EmbeddedSystemClass/Motor-Driver/README.md

# Motor-Driver

Collection of all boards past and presenet used by UOE Racing. Boards are organized by year of competition
