EmbeddedSystemClass/Motor-Driver/2019-2020/Diagrams/Motor Board Control Overview.png

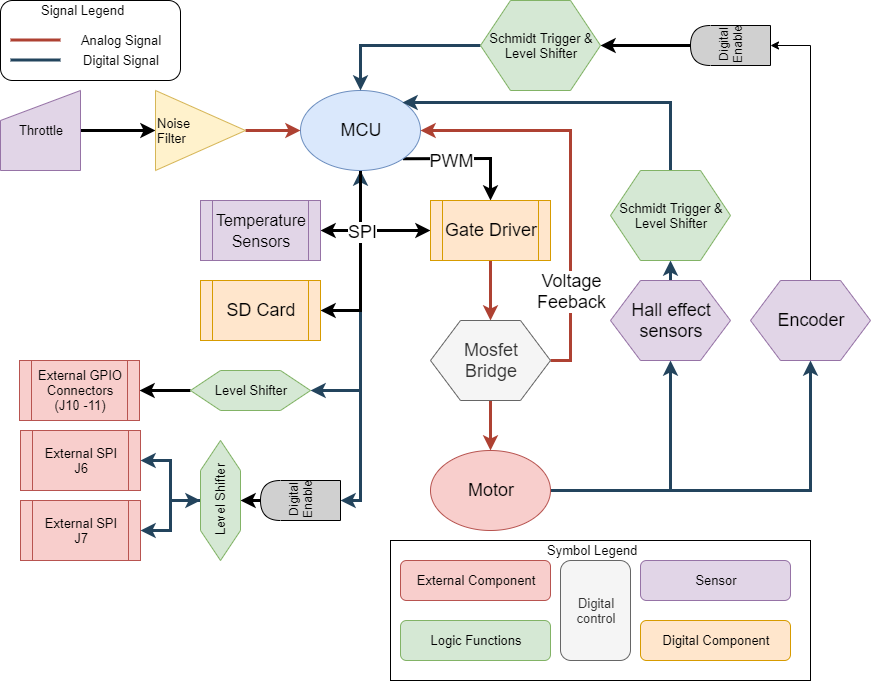
2019-2020/Diagrams/Motor Board Control Overview.png
