EmbeddedSystemClass/Motor-Driver/2019-2020/Diagrams/Power Block Diagram.png

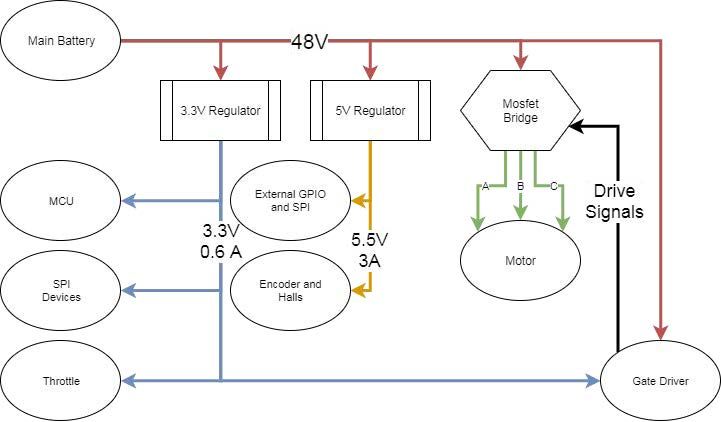
2019-2020/Diagrams/Power Block Diagram.png
