EmbeddedSystemClass/Motor-Driver/Part Libraries/ECAR_Refrence_Libary/OTHER/SW3639/NTAG I2C plus Class4 Antenna v1 screenshot.PNG

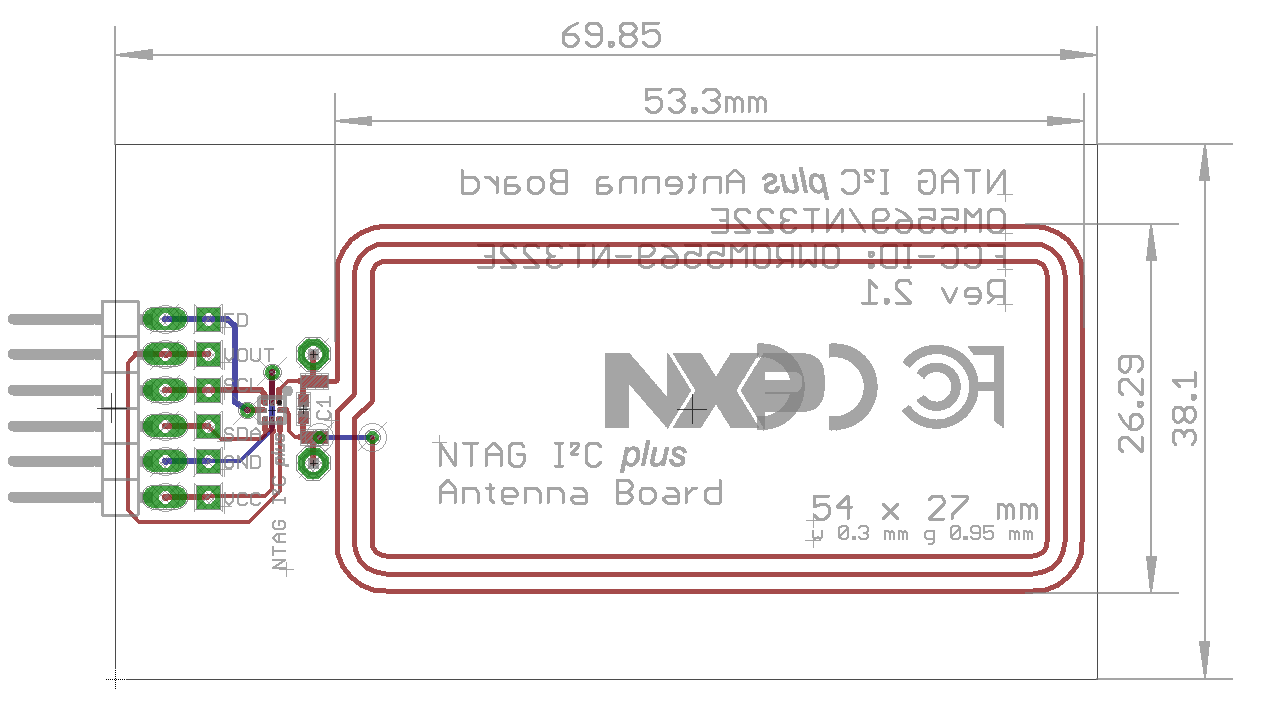
Part Libraries/ECAR_Refrence_Libary/OTHER/SW3639/NTAG I2C plus Class4 Antenna v1 screenshot.PNG
