EmbeddedSystemClass/Motor-Driver/Part Libraries/ECAR_Refrence_Libary/EReference-Schematic.csv

LIBRARYREFERENCE | FOOTPRINT1 | ACCURACY | CAPACITANCE | CASE CODE (IMPERIAL) | CASE CODE (METRIC) | CASE/PACKAGE | COLOUR | COMMENT | COMPONENTLINK1DESCRIPTION | COMPONENTLINK1URL | COMPONENTLINK2DESCRIPTION | COMPONENTLINK2URL | COMPONENTLINK3DESCRIPTION | COMPONENTLINK3URL | COMPONENTLINK4DESCRIPTION | COMPONENTLINK4URL | COMPONENTLINK5DESCRIPTION | COMPONENTLINK5URL | COMPONENTLINK6DESCRIPTION | COMPONENTLINK6URL | COMPONENTLINK7DESCRIPTION | COMPONENTLINK7URL | COMPONENTLINK8DESCRIPTION | COMPONENTLINK8URL | COMPOSITION | CONTACT PLATING | CONTINUOUS DRAIN CURRENT (ID) | CORE MATERIAL | CURRENT | CURRENT RATING | DATA RATE | DC RESISTANCE (DCR) | DEPTH | DIAMETER | DIELECTRIC | DIELECTRIC MATERIAL | DISSIPATION FACTOR | DOMINANT WAVELENGTH | DRAIN TO SOURCE BREAKDOWN VOLTAGE | DRAIN TO SOURCE RESISTANCE | DRAIN TO SOURCE VOLTAGE (VDSS) | DROPOUT VOLTAGE | ELEMENT CONFIGURATION | FALL TIME | FEATURES | FORWARD CURRENT | FORWARD VOLTAGE | FREQUENCY | GATE TO SOURCE VOLTAGE (VGS) | HALOGEN FREE | HEIGHT | HEIGHT - SEATED (MAX) | ILLUMINATION COLOUR | INDUCTANCE | INPUT CAPACITANCE | INTERFACE | LEAD DIAMETER | LEAD FREE | LEAD PITCH
ASMPH-1008-2R2M-T | INDC2521X10L |  |  | 1008 | 2520 | 1008 |  | 2.2uH | http://www.abracon.com/Magnetics/power/ASMPH-1008.pdf | http://www.abracon.com/Magnetics/power/ASMPH-1008.pdf |  |  |  |  |  |  |  |  |  |  |  |  |  |  |  |  |  | Ferrite |  | 1.3A |  | 80mR |  |  |  |  |  |  |  |  |  |  |  |  |  |  |  |  |  |  | 0.9mm | 0.039inch |  | 2.2uh
ASV-10.000MHZ-LCS-T | ASV-10.000MHZ-LCS-T |  |  |  |  |  |  | 10Mhz | DataSheet | https://abracon.com/Oscillators/ASV.pdf | Digikey Page | https://www.digikey.ca/product-detail/en/abracon-llc/ASV-10.000MHZ-LCS-T/535-13490-1-ND/5980162
C1005C0G1H680G050BA | CAPC1608X05L |  | 68pF | 0402 | 1005 | 0402 |  | 1uF | http://www.mouser.com/ds/2/400/lcc_commercial_general_en-837201.pdf | http://www.mouser.com/ds/2/400/lcc_commercial_general_en-837201.pdf | https://product.tdk.com/info/en/documents/chara_sheet/C1005C0G1H680G050BA.pdf | https://product.tdk.com/info/en/documents/chara_sheet/C1005C0G1H680G050BA.pdf |  |  |  |  |  |  |  |  |  |  |  |  |  |  |  |  |  |  |  |  | 0.5mm |  | C0G | Ceramic |  |  |  |  |  |  |  |  |  |  |  |  |  |  | 0.5mm |  |  |  |  |  |  | Lead Free
CC0603JRX7R9BB104 | CAPC1608X05L |  | 100nF | 0603 | 1608 | 0603 |  | 0.1uF | http://www.yageo.com/documents/recent/UPY-GPHC_X7R_6.3V-to-50V_8.pdf | http://www.yageo.com/documents/recent/UPY-GPHC_X7R_6.3V-to-50V_8.pdf |  |  |  |  |  |  |  |  |  |  |  |  |  |  | Ceramic |  |  |  |  |  |  |  | 0.8mm |  | X7R |  |  |  |  |  |  |  |  |  |  |  |  |  |  | Halogen Free | 0.8mm |  |  |  |  |  |  | Lead Free
CL10A106MQ8NNNC | CAPC1608X05L |  | 10uF | 0603 | 1608 | 0603 |  | 10uF | http://www.samsungsem.com/kr/support/library/product-catalog/mlcc.jsp | http://www.samsungsem.com/kr/support/library/product-catalog/mlcc.jsp | https://www.verical.com/server-webapp/html/getDatasheet?partID=357557 | https://www.verical.com/server-webapp/html/getDatasheet?partID=357557 | http://www1.futureelectronics.com/doc/SAMSUNG%20PASSIVE/CL05B104KQ5NNNC.pdf | http://www1.futureelectronics.com/doc/SAMSUNG%20PASSIVE/CL05B104KQ5NNNC.pdf |  |  |  |  |  |  |  |  |  |  |  | Tin |  |  |  |  |  |  | 0.8mm |  | X5R |  |  |  |  |  |  |  |  |  |  |  |  |  |  |  | 0.8mm
CL10A475MP5LNNC | CAPC1608X05L |  | 4.7uF | 0603 | 1608 | 0603 |  | 4.7uF |  |  |  |  |  |  |  |  |  |  |  |  |  |  |  |  |  | Tin |  |  |  |  |  |  |  |  | X5R
CL10F104ZB8NNNC | CAPC1608X05L |  | 100nF | 0603 | 1608 | 0603 |  | 0.1uF | http://www1.futureelectronics.com/doc/SAMSUNG/CL10F104ZB8NNNC.pdf | http://www1.futureelectronics.com/doc/SAMSUNG/CL10F104ZB8NNNC.pdf | https://www.verical.com/server-webapp/html/getDatasheet?partID=355329 | https://www.verical.com/server-webapp/html/getDatasheet?partID=355329 | https://www.distrelec.biz/Web/Downloads/_e/ng/MLCC_CatalogDownload2013_ENG.pdf?mime=application%2Fpdf | https://www.distrelec.biz/Web/Downloads/_e/ng/MLCC_CatalogDownload2013_ENG.pdf?mime=application%2Fpdf | https://produktinfo.conrad.com/datenblaetter/450000-474999/456692-da-01-en-VS_KONDENSATOR_0603.pdf | https://produktinfo.conrad.com/datenblaetter/450000-474999/456692-da-01-en-VS_KONDENSATOR_0603.pdf |  |  |  |  |  |  |  |  |  | Tin |  |  |  |  |  |  | 0.8mm |  | Y5V |  |  |  |  |  |  |  |  |  |  |  |  |  |  |  | 0.8mm
DRV8323RSRGZR | QFN50P700X700X100_HS-49N |  |  |  |  |  |  | *
ERA-3AEB121V | CAPC1608X05L |  |  | 0603 | 1608 | 0603 |  | 120 | http://www.farnell.com/datasheets/1776116.pdf | http://www.farnell.com/datasheets/1776116.pdf | https://www.distrelec.biz/Web/Downloads/_t/ds/ERA_eng_tds.pdf?mime=application%2Fpdf | https://www.distrelec.biz/Web/Downloads/_t/ds/ERA_eng_tds.pdf?mime=application%2Fpdf | http://www.farnell.com/datasheets/485442.pdf | http://www.farnell.com/datasheets/485442.pdf | http://www.farnell.com/datasheets/2052875.pdf | http://www.farnell.com/datasheets/2052875.pdf | http://www.farnell.com/datasheets/2059650.pdf | http://www.farnell.com/datasheets/2059650.pdf | http://industrial.panasonic.com/www-data/pdf/AOA0000/AOA0000CE26.pdf | http://industrial.panasonic.com/www-data/pdf/AOA0000/AOA0000CE26.pdf | http://uk.rs-online.com/webdocs/0fe2/0900766b80fe20f7.pdf | http://uk.rs-online.com/webdocs/0fe2/0900766b80fe20f7.pdf | https://produktinfo.conrad.com/datenblaetter/450000-474999/450380-da-01-en-WIDERSTAND_0603_ERA.pdf | https://produktinfo.conrad.com/datenblaetter/450000-474999/450380-da-01-en-WIDERSTAND_0603_ERA.pdf | Thin Film | Tin |  |  |  |  |  |  | 0.8mm |  |  |  |  |  |  |  |  |  |  |  | Automotive AEC-Q200 |  |  |  |  |  | 0.45mm |  |  |  |  |  |  | Lead Free
ERJ-M1WTF2M0U | RESC6532X08L |  |  | 2512 | 6432 | 2512 |  | 0.002 | http://uk.rs-online.com/webdocs/0bef/0900766b80befc3b.pdf | http://uk.rs-online.com/webdocs/0bef/0900766b80befc3b.pdf | http://www.farnell.com/datasheets/39800.pdf | http://www.farnell.com/datasheets/39800.pdf | http://www.farnell.com/datasheets/1678791.pdf | http://www.farnell.com/datasheets/1678791.pdf | http://www.mouser.com/ds/2/315/AOA0000CE7-60136.pdf | http://www.mouser.com/ds/2/315/AOA0000CE7-60136.pdf | https://www.alliedelec.com/m/d/7be8c991d0d271c40a5d4721d31e0fd6.pdf | https://www.alliedelec.com/m/d/7be8c991d0d271c40a5d4721d31e0fd6.pdf | https://industrial.panasonic.com/cdbs/www-data/pdf/RDN0000/AOA0000C90.pdf | https://industrial.panasonic.com/cdbs/www-data/pdf/RDN0000/AOA0000C90.pdf | http://industrial.panasonic.com/www-data/pdf/AOA0000/AOA0000CE7.pdf | http://industrial.panasonic.com/www-data/pdf/AOA0000/AOA0000CE7.pdf | https://www.alliedelec.com/m/d/0d7a6c47246abe4d76f460def559c8b0.pdf | https://www.alliedelec.com/m/d/0d7a6c47246abe4d76f460def559c8b0.pdf | Metal Element,Metal Strip,Thick Film | Tin |  |  |  |  |  |  | 3.2mm |  |  |  |  |  |  |  |  |  |  |  |  |  |  |  |  |  | 0.8mm |  |  |  |  |  |  | Lead Free
F280049CPMS | TSQFP50P1200X1200X145-64N |  |  |  |  |  |  | * | Digikey | https://www.digikey.ca/product-detail/en/texas-instruments/F280049CPMS/296-49637-ND/8322725 | Datasheet | http://www.ti.com/lit/ds/symlink/tms320f280049c.pdf | Ti Store Page | http://www.ti.com/product/tms320f280049c
FQD9N25TM_F080 | DPAK229P991X239-3N |  |  |  |  | TO-252-3 |  | * | https://www.fairchildsemi.com/tape-and-reel-drawings/PKG-TO252A03.pdf | https://www.fairchildsemi.com/tape-and-reel-drawings/PKG-TO252A03.pdf | https://www.fairchildsemi.com/datasheets/FQ/FQD9N25.pdf | https://www.fairchildsemi.com/datasheets/FQ/FQD9N25.pdf |  |  |  |  |  |  |  |  |  |  |  |  |  |  | 7.4A |  |  |  |  |  |  |  |  |  |  |  | 250V | 420mR | 250V |  | Single | 45ns |  |  |  |  | 30V |  |  |  |  |  | 700pF
ISO1050DUBR | SOP254P1040X485-8N |  |  |  |  | SOP |  |  | http://www.ti.com/lit/ds/symlink/iso1050.pdf | http://www.ti.com/lit/ds/symlink/iso1050.pdf | http://www.farnell.com/datasheets/1972904.pdf | http://www.farnell.com/datasheets/1972904.pdf | https://www.verical.com/server-webapp/html/getDatasheet?partID=330373 | https://www.verical.com/server-webapp/html/getDatasheet?partID=330373 | http://sg.element14.com/webapp/wcs/stores/servlet/OpenCAD?id=800000158048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 | http://sg.element14.com/webapp/wcs/stores/servlet/OpenCAD?id=800000158048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 | http://www.produktinfo.conrad.com/datenblaetter/1100000-1199999/001187118-da-01-en-IC_TXRX_CAN_5V_ISO_ISO1050DUBR_SOP_8_TID.pdf | http://www.produktinfo.conrad.com/datenblaetter/1100000-1199999/001187118-da-01-en-IC_TXRX_CAN_5V_ISO_ISO1050DUBR_SOP_8_TID.pdf | http://datasheet.iiic.cc/texas_instruments/ISO1050DUBR.pdf | http://datasheet.iiic.cc/texas_instruments/ISO1050DUBR.pdf |  |  |  |  |  | Gold |  |  |  |  | 1Mbps |  |  |  |  |  |  |  |  |  |  |  |  |  |  |  |  |  |  |  |  |  |  |  |  |  |  | Lead Free
LTST-C191KRKT | CAPC1608X05L - Polarized |  |  | 0603 | 1608 | 0603 | Red | RED LED | http://optoelectronics.liteon.com/upload/download/DS22-2000-223/LTST-C191KRKT.PDF | http://optoelectronics.liteon.com/upload/download/DS22-2000-223/LTST-C191KRKT.PDF | http://www1.futureelectronics.com/doc/LITE-ON/LTST-C191KRKT.pdf | http://www1.futureelectronics.com/doc/LITE-ON/LTST-C191KRKT.pdf | https://www.verical.com/server-webapp/html/getDatasheet?partID=141922 | https://www.verical.com/server-webapp/html/getDatasheet?partID=141922 | http://www.mouser.com/ds/2/239/LTST-C191KRKT-1140668.pdf | http://www.mouser.com/ds/2/239/LTST-C191KRKT-1140668.pdf |  |  |  |  |  |  |  |  |  |  |  |  | 2A |  |  |  | 0.8mm |  |  |  |  | 631nm |  |  |  |  |  |  |  | 30mA | 2V |  |  |  | 0.55mm |  | Red |  |  |  |  | Lead Free
NT3H2211W0FT1X | SOP254P1040X485-8N |  |  |  |  | SOIC |  | * |  |  |  |  |  |  |  |  |  |  |  |  |  |  |  |  |  |  |  |  |  |  |  |  |  |  |  |  |  |  |  |  |  |  |  |  |  |  |  | 13.56MHz |  |  |  |  |  |  |  | I2C
RC0603JR-0743RL | CAPC1608X05L |  |  | 0603 | 1608 | 0603 |  | 43 | http://www.yageo.com/documents/recent/PYu-RC_Group_51_RoHS_L_9.pdf | http://www.yageo.com/documents/recent/PYu-RC_Group_51_RoHS_L_9.pdf | http://www.yageo.com.tw/exep/pages/download/literatures/PYu-R_INT-thick_7.pdf | http://www.yageo.com.tw/exep/pages/download/literatures/PYu-R_INT-thick_7.pdf | http://www.mouser.com/ds/2/447/RC0603-272842.pdf | http://www.mouser.com/ds/2/447/RC0603-272842.pdf |  |  |  |  |  |  |  |  |  |  | Thick Film | Matte,Tin |  |  |  |  |  |  | 0.8mm |  |  |  |  |  |  |  |  |  |  |  | Moisture Resistant |  |  |  |  |  | 0.022inch |  |  |  |  |  |  | Lead Free
RR0816P-103-D | CAPC1608X05L |  |  | 0603 | 1608 | 0603 |  | 10k | http://documents.rs-components.com/techlib://itc_doclist_GB.htm?stockno=3915321 | http://documents.rs-components.com/techlib://itc_doclist_GB.htm?stockno=3915321 | http://www.susumu.co.jp/common/pdf/n_catalog_partition05_en.pdf | http://www.susumu.co.jp/common/pdf/n_catalog_partition05_en.pdf |  |  |  |  |  |  |  |  |  |  |  |  | Thin Film |  |  |  |  |  |  |  | 0.8mm |  |  |  |  |  |  |  |  |  |  |  |  |  |  |  |  |  | 0.4mm |  |  |  |  |  |  | Lead Free
SMD Jumper |  |  |  |  |  |  |  | *
SSM3J35MFV,L3F | SOTFL40P120X55-3N |  |  |  |  | SOT-723 |  | * |  |  |  |  |  |  |  |  |  |  |  |  |  |  |  |  |  |  | 100mA |  |  |  |  |  |  |  |  |  |  |  |  |  | 20V |  |  |  |  |  |  |  |  |  |  |  |  |  | 12.2pF
UA78L05ACPK | SOT89-150P410X160-3N | 5% |  |  |  | SOT-89 |  |  | https://www.verical.com/server-webapp/html/getDatasheet?partID=40762 | https://www.verical.com/server-webapp/html/getDatasheet?partID=40762 | http://www.ti.com/lit/ds/symlink/ua78l.pdf | http://www.ti.com/lit/ds/symlink/ua78l.pdf | http://focus.ti.com/lit/ds/symlink/ua78l12a.pdf | http://focus.ti.com/lit/ds/symlink/ua78l12a.pdf | http://www.ti.com/general/docs/lit/getliterature.tsp?genericPartNumber=UA78L05&&fileType=pdf | http://www.ti.com/general/docs/lit/getliterature.tsp?genericPartNumber=UA78L05&&fileType=pdf | http://www.jameco.com/Jameco/Products/ProdDS/764220.pdf | http://www.jameco.com/Jameco/Products/ProdDS/764220.pdf | http://www.farnell.com/datasheets/1848990.pdf | http://www.farnell.com/datasheets/1848990.pdf |  |  |  |  |  | Matte,Tin |  |  |  |  |  |  |  |  |  |  |  |  |  |  |  | 1.7V |  |  |  |  |  |  |  |  |  |  |  |  |  |  |  | Lead Free
UMK107AB7105KA-T | CAPC1608X05L |  | 1uF | 0603 | 1608 | 0603 |  | 1uF | https://www.yuden.co.jp/productdata/catalog/mlcc_all_e.pdf | https://www.yuden.co.jp/productdata/catalog/mlcc_all_e.pdf |  |  |  |  |  |  |  |  |  |  |  |  |  |  |  |  |  |  |  |  |  |  | 0.8mm |  | X7R |  |  |  |  |  |  |  |  |  |  |  |  |  |  | Halogen Free | 0.8mm
UWT0J102MNL1GS | CAPAE109103X100N |  | 1mF |  |  | Radial |  | 1000uF | http://www.nichicon.co.jp/english/products/pdfs/e-ch_ref.pdf | http://www.nichicon.co.jp/english/products/pdfs/e-ch_ref.pdf | http://uk.rs-online.com/webdocs/0fa3/0900766b80fa3a91.pdf | http://uk.rs-online.com/webdocs/0fa3/0900766b80fa3a91.pdf | http://nichicon-us.com/english/products/pdfs/e-uwt.pdf | http://nichicon-us.com/english/products/pdfs/e-uwt.pdf | http://products.nichicon.co.jp/en/pdf/XJA043/e-wt.pdf | http://products.nichicon.co.jp/en/pdf/XJA043/e-wt.pdf | http://www.farnell.com/datasheets/1910938.pdf | http://www.farnell.com/datasheets/1910938.pdf | http://nichicon-us.com/english/products/pdfs/e-wt.pdf | http://nichicon-us.com/english/products/pdfs/e-wt.pdf |  |  |  |  |  |  |  |  |  |  |  |  |  | 8mm |  | Aluminium | 0.3% |  |  |  |  |  |  |  | General Purpose |  |  |  |  |  | 10mm | 0.315inch |  |  |  |  | 1.1mm | Lead Free | 3.1mm
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
