EmbeddedSystemClass/Motor-Driver/2018-19/Project Outputs for MOSFET Board Project/Power_Board_Layout_V2.xls

Sheet: Part List Report
 | Component list |  |  | Bill of Materials For PCB Document [Power_Board_Layout_V2.PcbDoc]
 | Source Data From: V2 |  |  | Mosfet Board V2
 | Project: BLDC Contorller Power Section |  |  | Generated from : 'Power_Board_Layout_V2.PcbDoc
 | Report Date: |  | 2/15/2019 | 10:30:46 AM
 | Print Date: |  | 2019-02-18 | 11:54:25
# | Designator | Manufacturer | Manufacturer Part Number | Value | Footprint | Description | Quantity | Price
1 | C1 | AVX Corporation | 08055C103KAT2A | 100nF | 805 | CAP CER 10000PF 50V X7R 0805 | 1 | 0.21
2 | C13, C16, C2 | Taiyo Yuden | UMK212B7105KG-T | 1uF | 805 | CAP CER 1UF 50V X7R 0805 | 3 | 0.3
3 | C14, C19, C20, C21 | Murata | GCJ188R71H473KA12D | 47nF | 603 | 0.047µF ±10% 50V Ceramic Capacitor X7R 0603 (1608 Metric) | 4 | 0.45
4 | C15, C17 | Yageo | CC0603KRX7R9BB104 | 0.1uF | 603 | CAP CER 0.1UF 50V X7R 0603 | 2 | 0.17
 | C3 | Murata | GRT21BR61E226ME13L | 22uF | 805 | CAP CER 22UF 25V X5R 0805 | 1 | 1.03
6 | C4, C5, C6 | Panasonic | ECA-1JHG471 | 470uF | Through Hole | Cap Aluminum Lytic 470uF 63V 20% (12.5 X 20mm) Radial 5mm 640mA 2000h 105C Bulk | 3 | 1.35
7 | C7, C8, C9 | Kyocera AVX | 06035C163KAT2A | 16nF | 603 | CAP CER 0.016UF 50V X7R 0603 | 3 | 0.5
8 | D1, D2 | Vishay Lite-On | LTST-C191KRKT |  | 603 | LED RED CLEAR 0603 SMD | 2 | 0.41
9 | D3, D4 | Micro Commercial | SMBJ5362B-TP |  |  | DIODE ZENER 28V 5W DO214AA | 2 | 0.96
10 | J3 | Molex | 39301240 |  | Through Hole | CONN HEADER R/A 24POS 4.2MM | 1 | 5.56
 | J6 | Hirose | DF3A-5P-2DSA |  | Through Hole | CONN HEADER VERT 5POS 2MM | 1 | 0.37
12 | L1 | Bourns INC | SRR6038-100Y | 10uH | Non-Standard SMT | FIXED IND 10UH 2A 38 MOHM SMD | 1 | 1.31
13 | Q1, Q2, Q3, Q4, Q5, Q6 | Texas Instruments | CSD18536KTTT |  | DPAK254P1510X470-3M | MOSFET N-CH 60V 200A D2PAK | 6 | 7.44
14 | R1 | Susumu | RR0816P-104-D | 100k | 603 | RES SMD 100K OHM 0.5% 1/16W 0603 | 1 | 0.17
15 | R15, R16, R17 | Stackpole Electronics | CSNL2512FT1L00 | 0.001 | RESC8032X08N | RES 0.001 OHM 1% 2W 2512 | 3 | 1.03
16 | R2 | Yageo | RC0603FR-0722KL | 22k | 603 | RES SMD 22K OHM 1% 1/10W 0603 | 1 | 0.15
17 | R20, R21, R22 | Panasonic | ERA-3AEB4222V | 42.2K | 603 | RES SMD 42.2KOHM 0.1% 1/10W 0603 | 3 | 0.53
18 | R23, R24, $25 | Panasonic | ERA-3AEB4991V | 4.99K | 603 | RES SMD 4.99KOHM 0.1% 1/10W 0603 | 3 | 0.53
19 | R3, R4, R5, R11, R12, R18, R19 | Stackpole Electronics | RMCF0603JT10K0 | 10k | 603 | RES 10K OHM 5% 1/10W 0603 | 7 | 0.15
20 | R6, R7, R8, R10, R13, R14 | TE Connectivity | CRG0603J100R | 100 | 603 | RES SMD 100 OHM 5% 1/10W 0603 | 6 | 0.15
21 | R9 | Rohm | SDR03EZPJ152 | 1.5K | 0805 Res | RES SMD 1.5 KOHM 5% 0.3W 0603 | 1 | 0.15
22 | TP1, TP2, TP3, TP13 | TE Connectivity | RCU-0C |  |  | PC TEST POINT NATURAL | 4 | 0.31
23 | U1 | Texas Instruments | TPS54308DDCR |  | SOT95P280X110-6N | FCCM SYNCHRONOUS STEP DOWN CONVE | 1 | 2.42
24 | U2 | Texas Instruments | DRV8323RSRGZT |  | QFN50P700X700X100_HS-49N | IC MTR DRV MULTIPHAS 6-60V 48QFN | 1 | 8.97
Approved |  |  |  | Notes |  |  | 61 | 95.62
 |  |  |  | Prepared By Camry Mabon

Sheet: Project Information
Project Full Path | C:\Users\squir\Desktop\bldc_power_board\MOSFET Board Project.PrjPCB
Project Filename | MOSFET Board Project.PrjPCB
Variant Name | None
Data-Source Filename | Power_Board_Layout_V2.PcbDoc
Data-Source Full Path | C:\Users\squir\Desktop\bldc_power_board\Power_Board_Layout_V2.PcbDoc
Title | Bill of Materials For PCB Document [Power_Board_Layout_V2.PcbDoc]
Total Quantity | 65
Report Time | 10:30:46 AM
Report Date | 2/15/2019
Report Date & Tine | 2/15/2019 10:30:46 AM
Output Name | Bill of Materials
Output Type | BOM_PartType
Output Generator Name | BOM
Output Generator Description | Bill of Materials
Total Actual Price | 0
Total Target Price | 0
