EmbeddedSystemClass/Motor-Driver/2018-19/Power_Board_Layout_V2.step

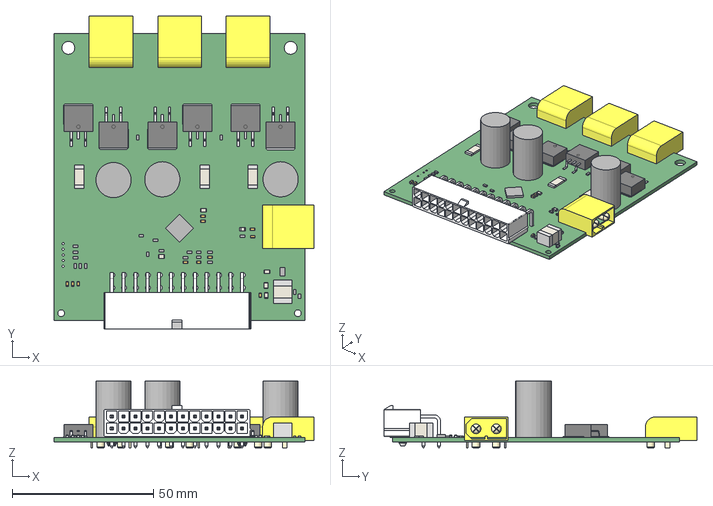
[picture p4: CAD file, 2019-07-14]
2018-19/Power_Board_Layout_V2.step
92.1 x 110.7 x 23.6 mm
