EmbeddedSystemClass/Motor-Driver/Part Libraries/ECAR_Refrence_Libary/OTHER/3D Models/MPT-06-01-03-L-RA-SD.stp

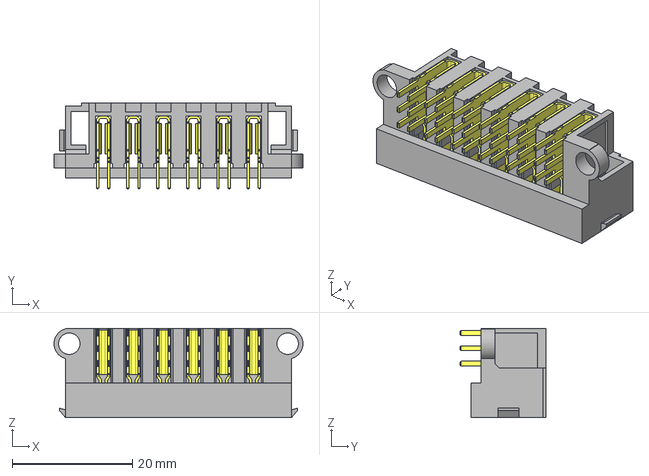
[picture p5: CAD file, 2019-12-08]
Part Libraries/ECAR_Refrence_Libary/OTHER/3D Models/MPT-06-01-03-L-RA-SD.stp
41.4 x 14.3 x 14.8 mm
_MPT06terminal2
_MPT0603pins2
