EmbeddedSystemClass/Motor-Driver/Part Libraries/ECAR_Refrence_Libary/OTHER/3D Models/MPT-04-01-01-L-RA-SD.stp

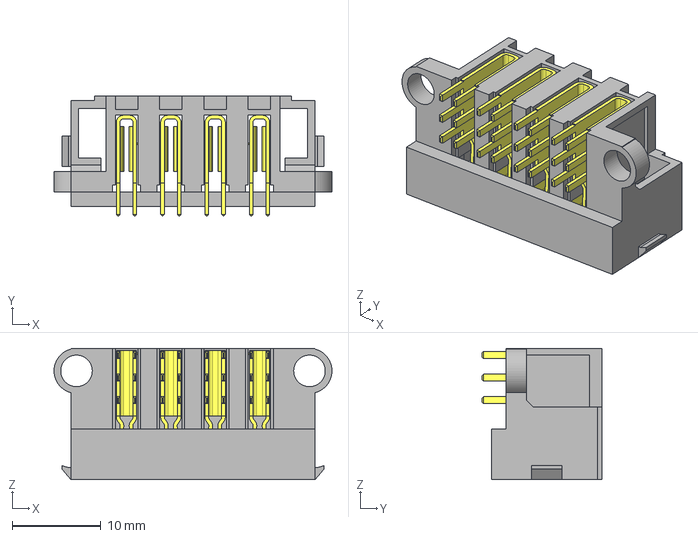
[picture p6: CAD file, 2019-12-08]
Part Libraries/ECAR_Refrence_Libary/OTHER/3D Models/MPT-04-01-01-L-RA-SD.stp
31.4 x 13.5 x 14.8 mm
_MPT04terminal2
_MPT0401pins2
