EmbeddedSystemClass/Motor-Driver/Part Libraries/ECAR_Refrence_Libary/OTHER/3D Models/IPL1-103-01-L-S-RA-K.stp

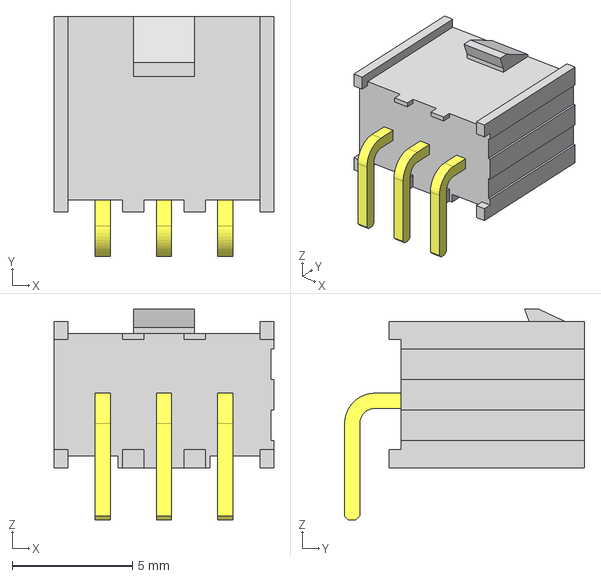
[picture p7: CAD file, 2019-10-10]
Part Libraries/ECAR_Refrence_Libary/OTHER/3D Models/IPL1-103-01-L-S-RA-K.stp
9.14 x 9.97 x 8.76 mm
_IPL1-103-01-S-RA-K_header
_T-1S64-01-03-S-RA
