EmbeddedSystemClass/Motor-Driver/Part Libraries/ECAR_Refrence_Libary/OTHER/3D Models/SSW-110-23-F-D.stp

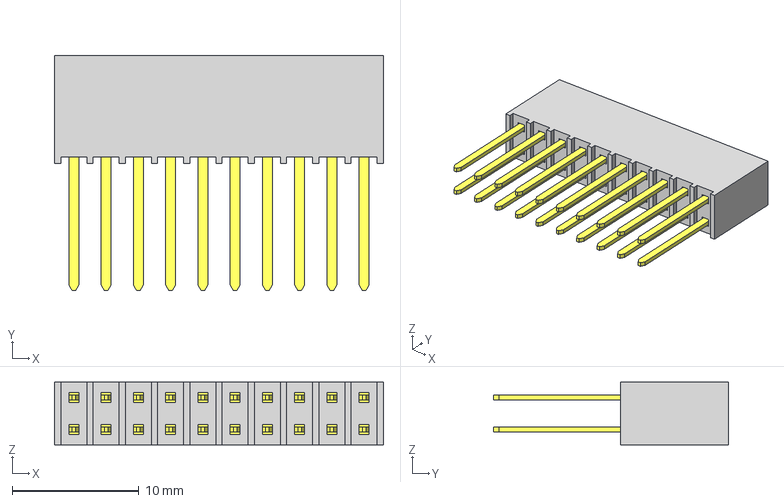
[picture p8: CAD file, 2019-10-10]
Part Libraries/ECAR_Refrence_Libary/OTHER/3D Models/SSW-110-23-F-D.stp
25.9 x 18.5 x 4.95 mm
_T1SSW-110-23-F-D
_P2SSW-110-23-F-D
