EmbeddedSystemClass/Motor-Driver/Part Libraries/ECAR_Refrence_Libary/OTHER/3D Models/TSS-110-01-G-D.stp

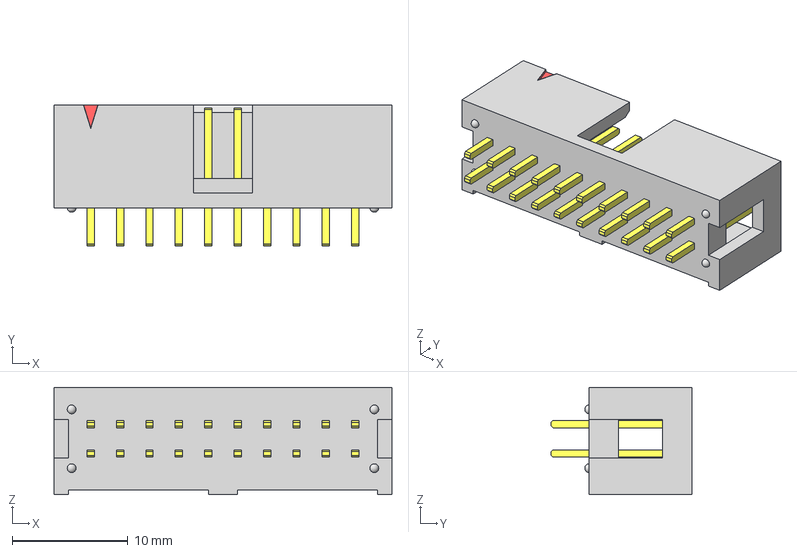
[picture p9: CAD file, 2019-10-10]
Part Libraries/ECAR_Refrence_Libary/OTHER/3D Models/TSS-110-01-G-D.stp
29.2 x 12.2 x 9.27 mm
_TSS-110-01-D_header
_TSS-First_Position_Indicator
_T-1S6-10-01-D__
