EmbeddedSystemClass/Motor-Driver/Part Libraries/ECAR_Refrence_Libary/OTHER/3D Models/MPT-03-6.30-01-L-V.stp

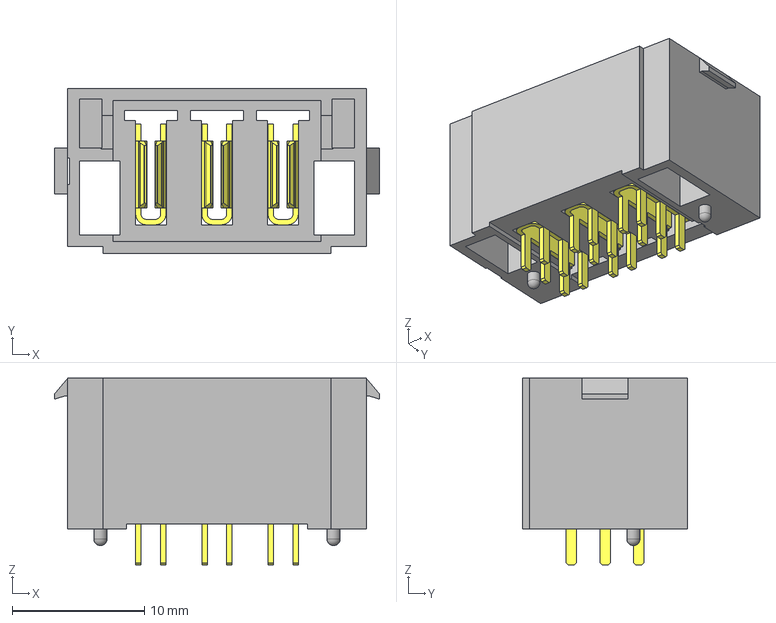
[picture p10: CAD file, 2019-10-10]
Part Libraries/ECAR_Refrence_Libary/OTHER/3D Models/MPT-03-6.30-01-L-V.stp
24.6 x 12.4 x 14.1 mm
_MPT03-SDterminal1
_MPT0301pins3
