EmbeddedSystemClass/Motor-Driver/Part Libraries/ECAR_Refrence_Libary/OTHER/3D Models/MPT-02-6.30-01-L-V.stp

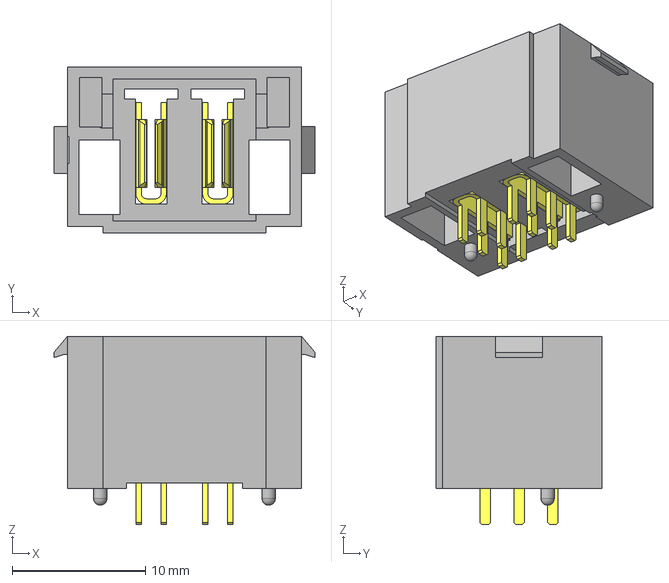
[picture p11: CAD file, 2019-10-10]
Part Libraries/ECAR_Refrence_Libary/OTHER/3D Models/MPT-02-6.30-01-L-V.stp
19.6 x 12.4 x 14.1 mm
_MPT02-SDterminal1
_MPT0201pins3
