EmbeddedSystemClass/Motor-Driver/Part Libraries/ECAR_Refrence_Libary/OTHER/3D Models/IPL1-103-01-L-D-RA-K.stp

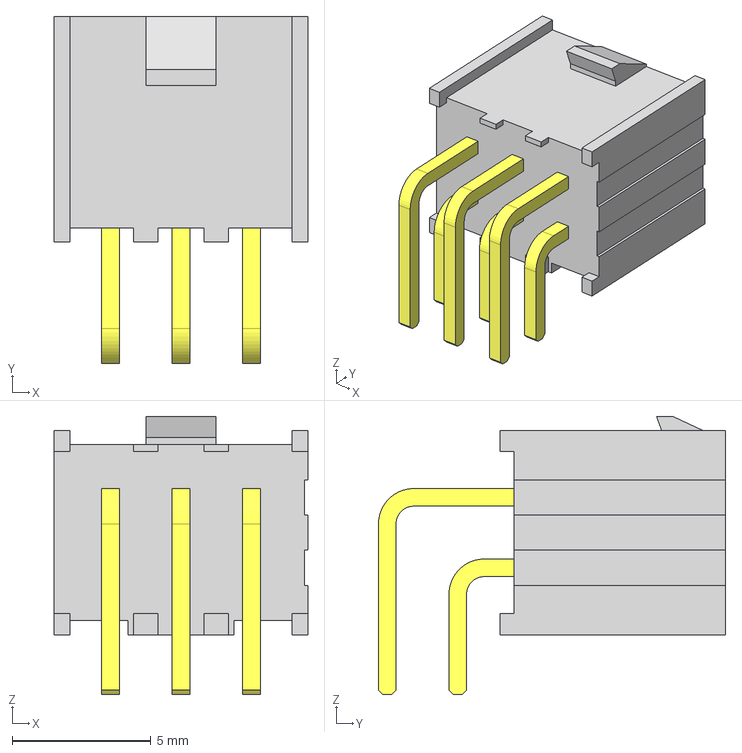
[picture p12: CAD file, 2019-09-27]
Part Libraries/ECAR_Refrence_Libary/OTHER/3D Models/IPL1-103-01-L-D-RA-K.stp
9.14 x 12.5 x 10.0 mm
_IPL1-103-01-D-RA-K_header
_T-1S64-01-03-D-RA
