EmbeddedSystemClass/Motor-Driver/Part Libraries/ECAR_Refrence_Libary/OTHER/3D Models/WSL2726 (0.0013).step

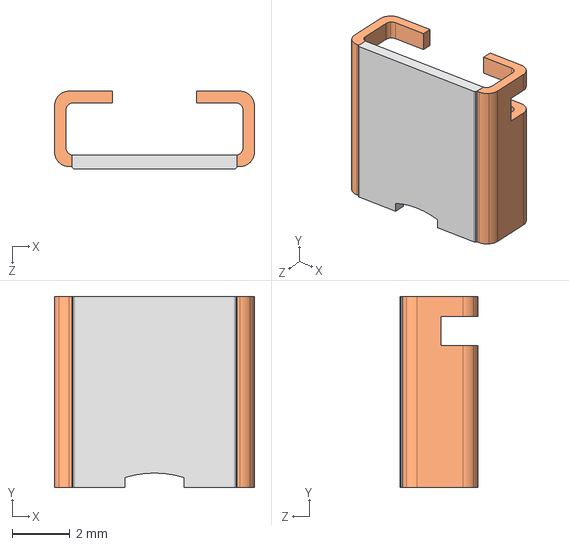
[picture p13: CAD file, 2019-09-27]
Part Libraries/ECAR_Refrence_Libary/OTHER/3D Models/WSL2726 (0.0013).step
6.90 x 6.60 x 2.68 mm
