EmbeddedSystemClass/Motor-Driver/Part Libraries/ECAR_Refrence_Libary/OTHER/3D Models/ASV.STEP

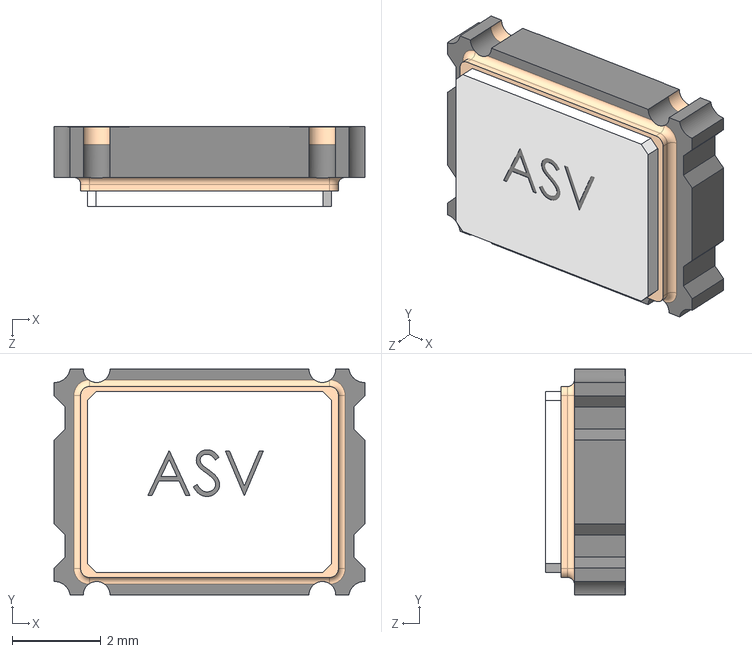
[picture p14: CAD file, 2019-07-14]
Part Libraries/ECAR_Refrence_Libary/OTHER/3D Models/ASV.STEP
7.00 x 5.08 x 1.80 mm
