EmbeddedSystemClass/Motor-Driver/Part Libraries/ECAR_Refrence_Libary/OTHER/3D Models/039300240.stp

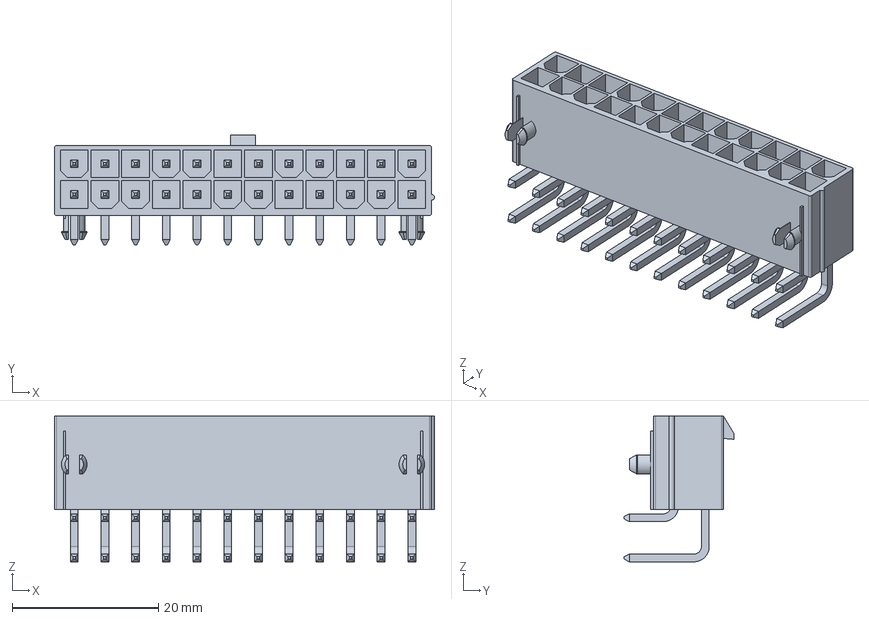
[picture p15: CAD file, 2019-07-14]
Part Libraries/ECAR_Refrence_Libary/OTHER/3D Models/039300240.stp
52.0 x 15.0 x 19.9 mm
