EmbeddedSystemClass/Motor-Driver/Part Libraries/Old Libary/CAD Part Models/CARD EDGE.stp

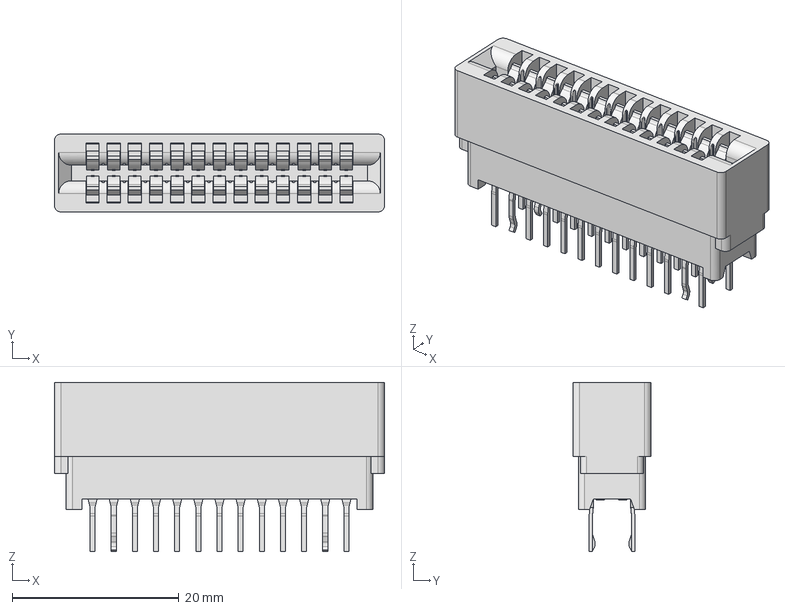
[picture p16: CAD file, 2019-07-14, an earlier design]
Part Libraries/Old Libary/CAD Part Models/CARD EDGE.stp
39.6 x 9.35 x 20.3 mm
