EmbeddedSystemClass/Motor-Driver/Part Libraries/Old Libary/CAD Part Models/c-350211-1-af-3d.stp

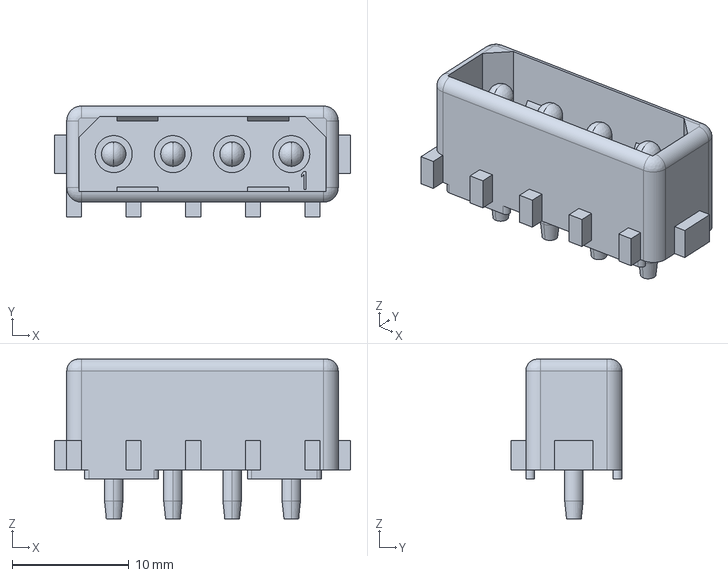
[picture p17: CAD file, 2019-07-14, an earlier design]
Part Libraries/Old Libary/CAD Part Models/c-350211-1-af-3d.stp
25.4 x 9.53 x 13.7 mm
