EmbeddedSystemClass/Motor-Driver/Part Libraries/Old Libary/CAD Part Models/XT60-PW.stp

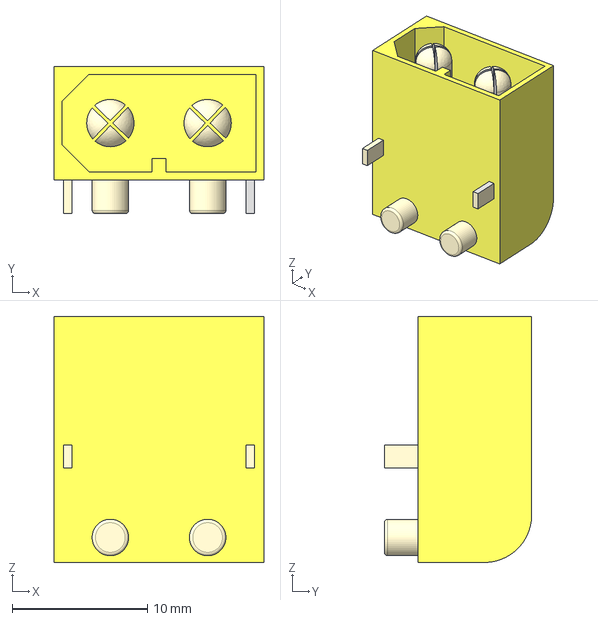
[picture p18: CAD file, 2019-07-14, an earlier design]
Part Libraries/Old Libary/CAD Part Models/XT60-PW.stp
15.5 x 10.9 x 18.2 mm
