EmbeddedSystemClass/Motor-Driver/Part Libraries/Old Libary/CAD Part Models/1722981104.stp

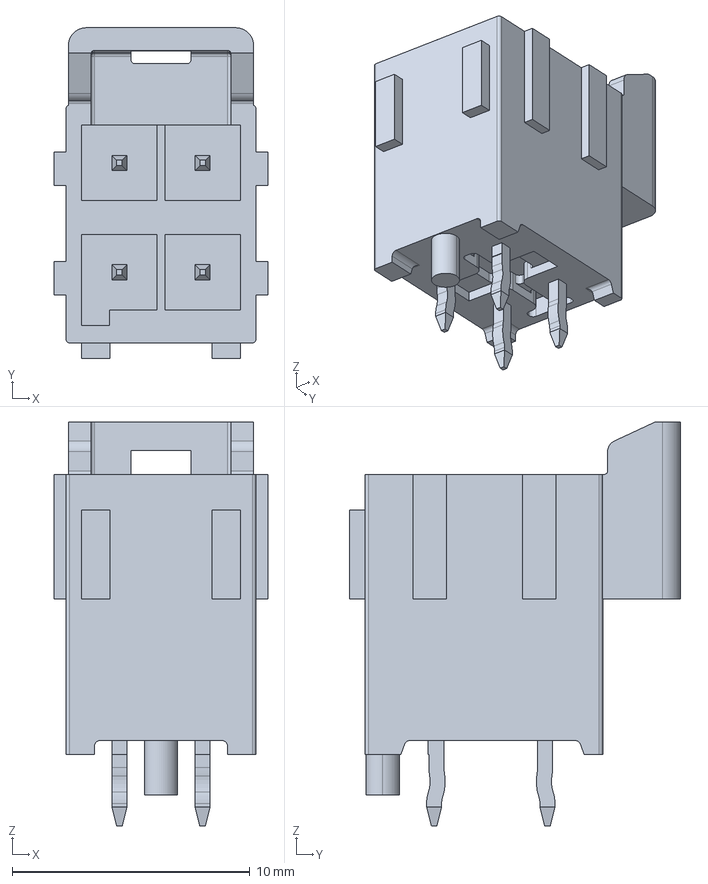
[picture p19: CAD file, 2019-07-14, an earlier design]
Part Libraries/Old Libary/CAD Part Models/1722981104.stp
9.00 x 13.9 x 17.0 mm
