EmbeddedSystemClass/Motor-Driver/(list of files, cad)

Other CAD files:
Part Libraries/Old Libary/CAD Part Models/c-5145274-1-d-3d.stp
Part Libraries/Old Libary/CAD Part Models/c-5145274-1-d-3d.dwg
Part Libraries/Old Libary/CAD Part Models/c-5145274-1-d-3d.obj
Part Libraries/Old Libary/CAD Part Models/c-5145274-1-d-3d.stl
Part Libraries/Old Libary/CAD Part Models/c-5145274-1-d-3d.x_b
