EmbeddedSystemClass/Motor-Driver/2019-2020/Output Docuements/External Outputs/BLDC Controller - 2020 - Mechanical Drawing and Information.pdf

# Symbol B

262 841

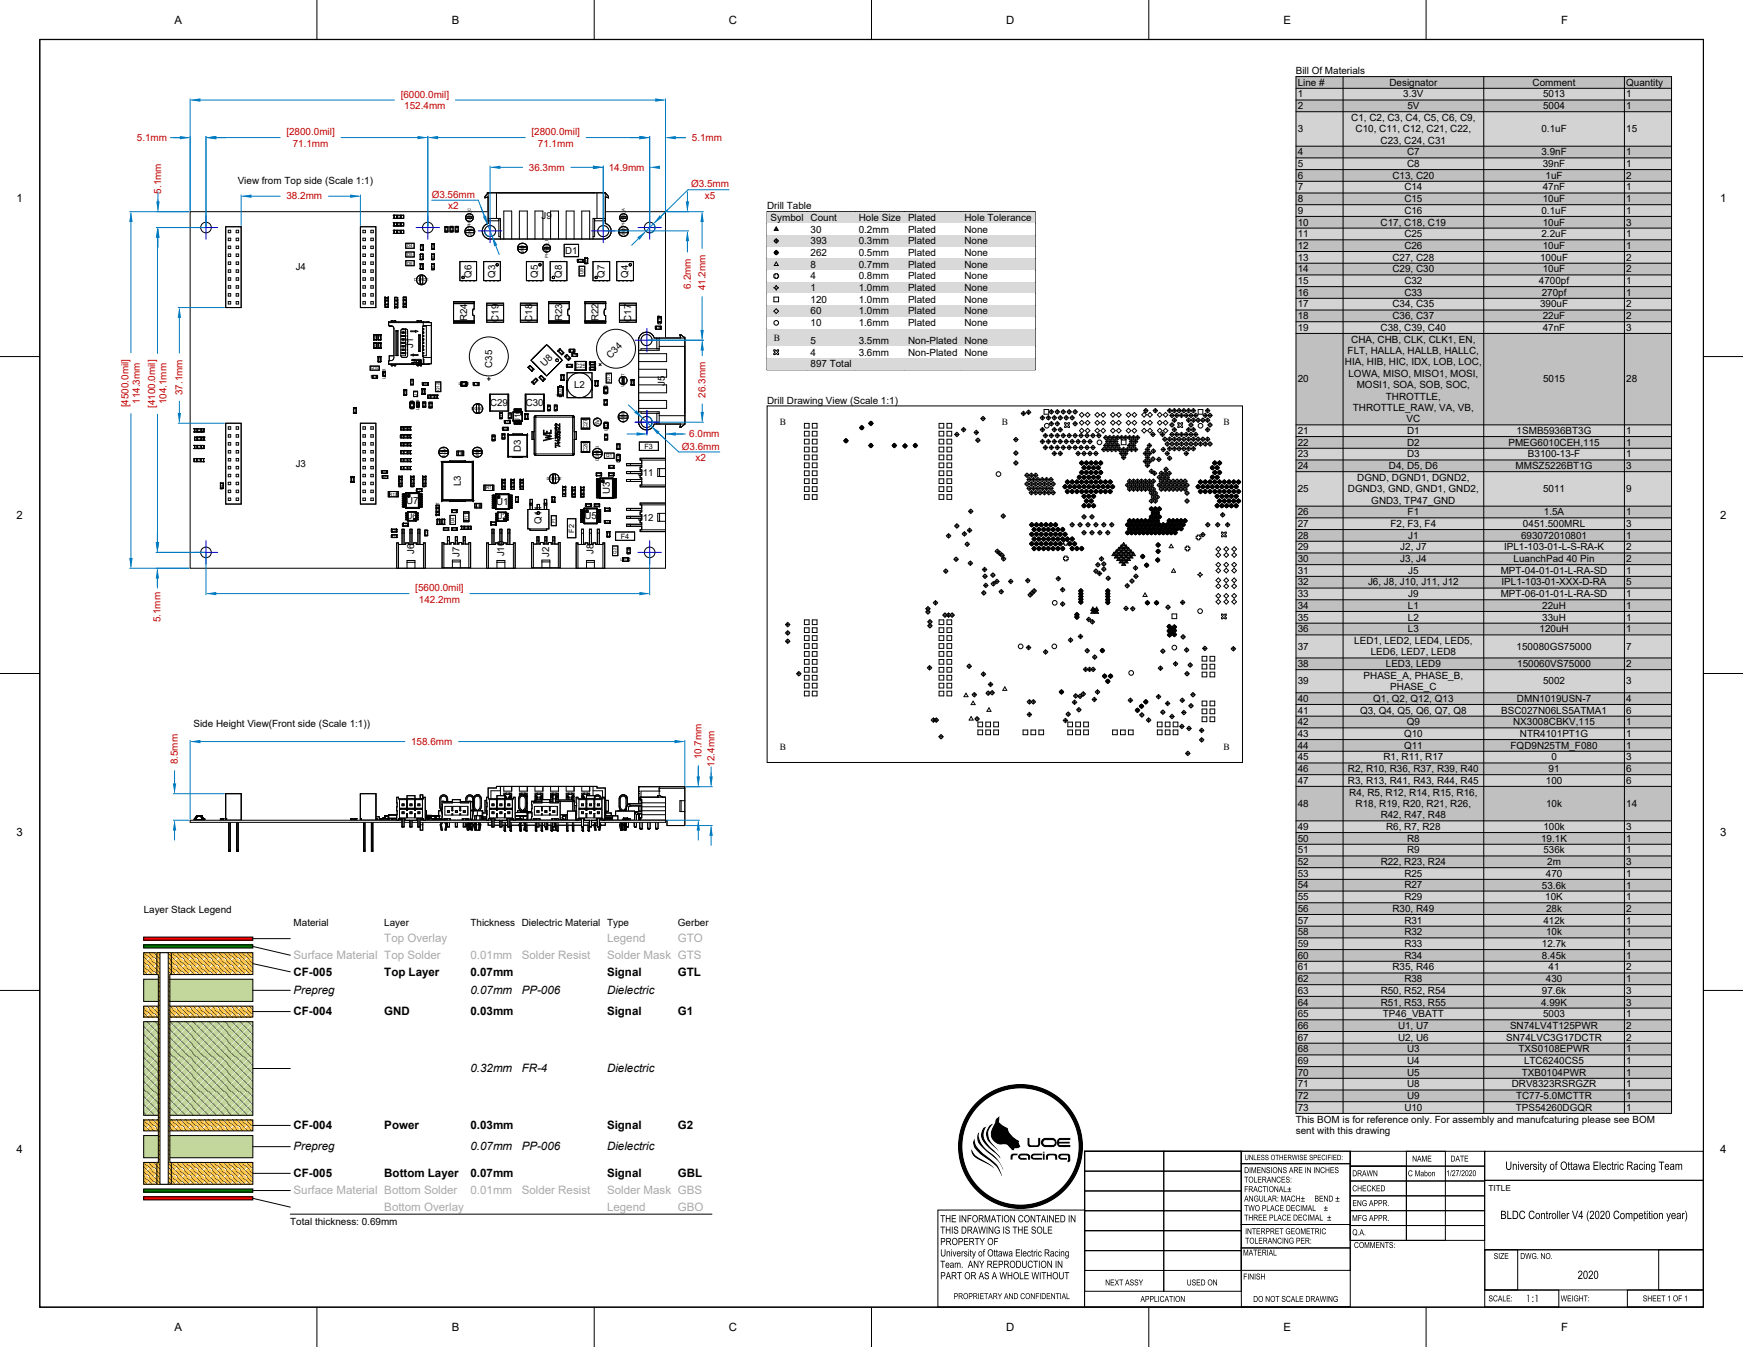
[picture p20: page 1]

View from Top side (Scale 1:1)

CHA, CHB, CLK, CLK1, EN,
FLT, HALLA, HALLB, HALLC,
HIA, HIB, HIC, IDX, LOB, LOC,
LOWA, MISO, MISO1, MOSI,

Drill Drawing View (Scale 1:1)

Side Height View(Front side (Scale 1:1))
