EmbeddedSystemClass/Motor-Driver/2018-19/MOSFET Board Project_1.pdf

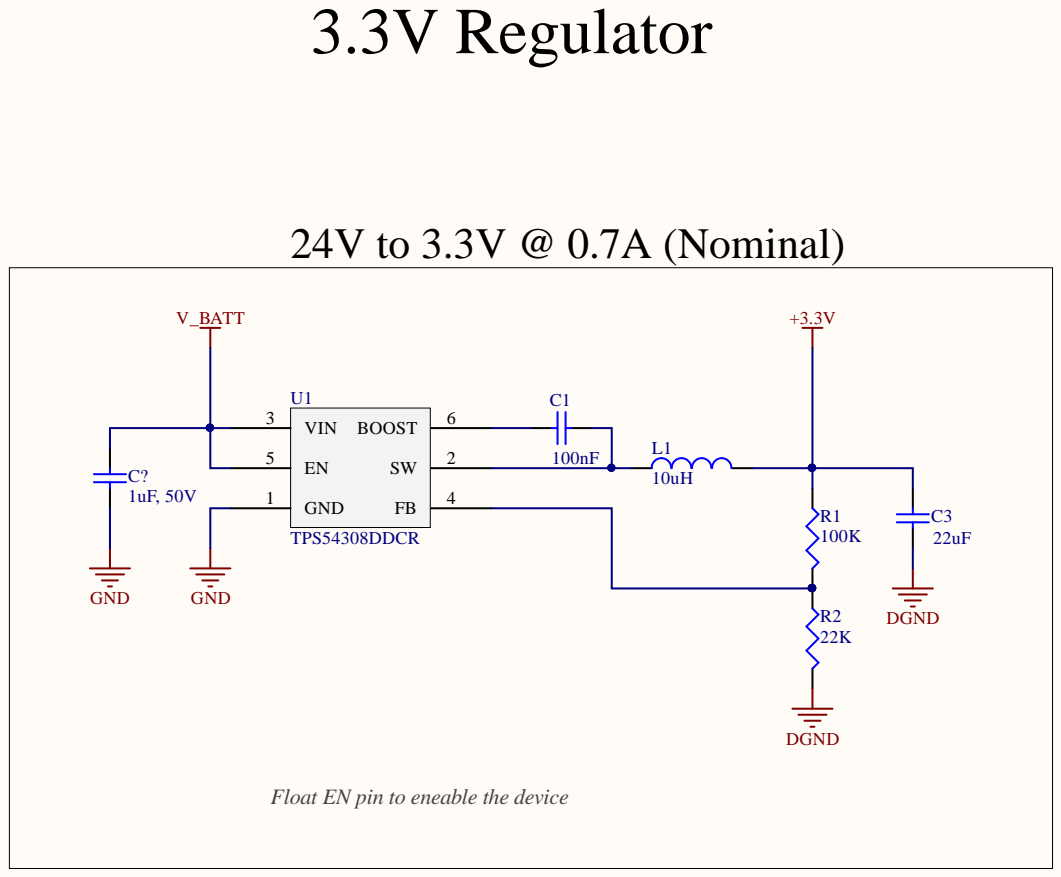
[picture p21: page 1]

at EN pin to e

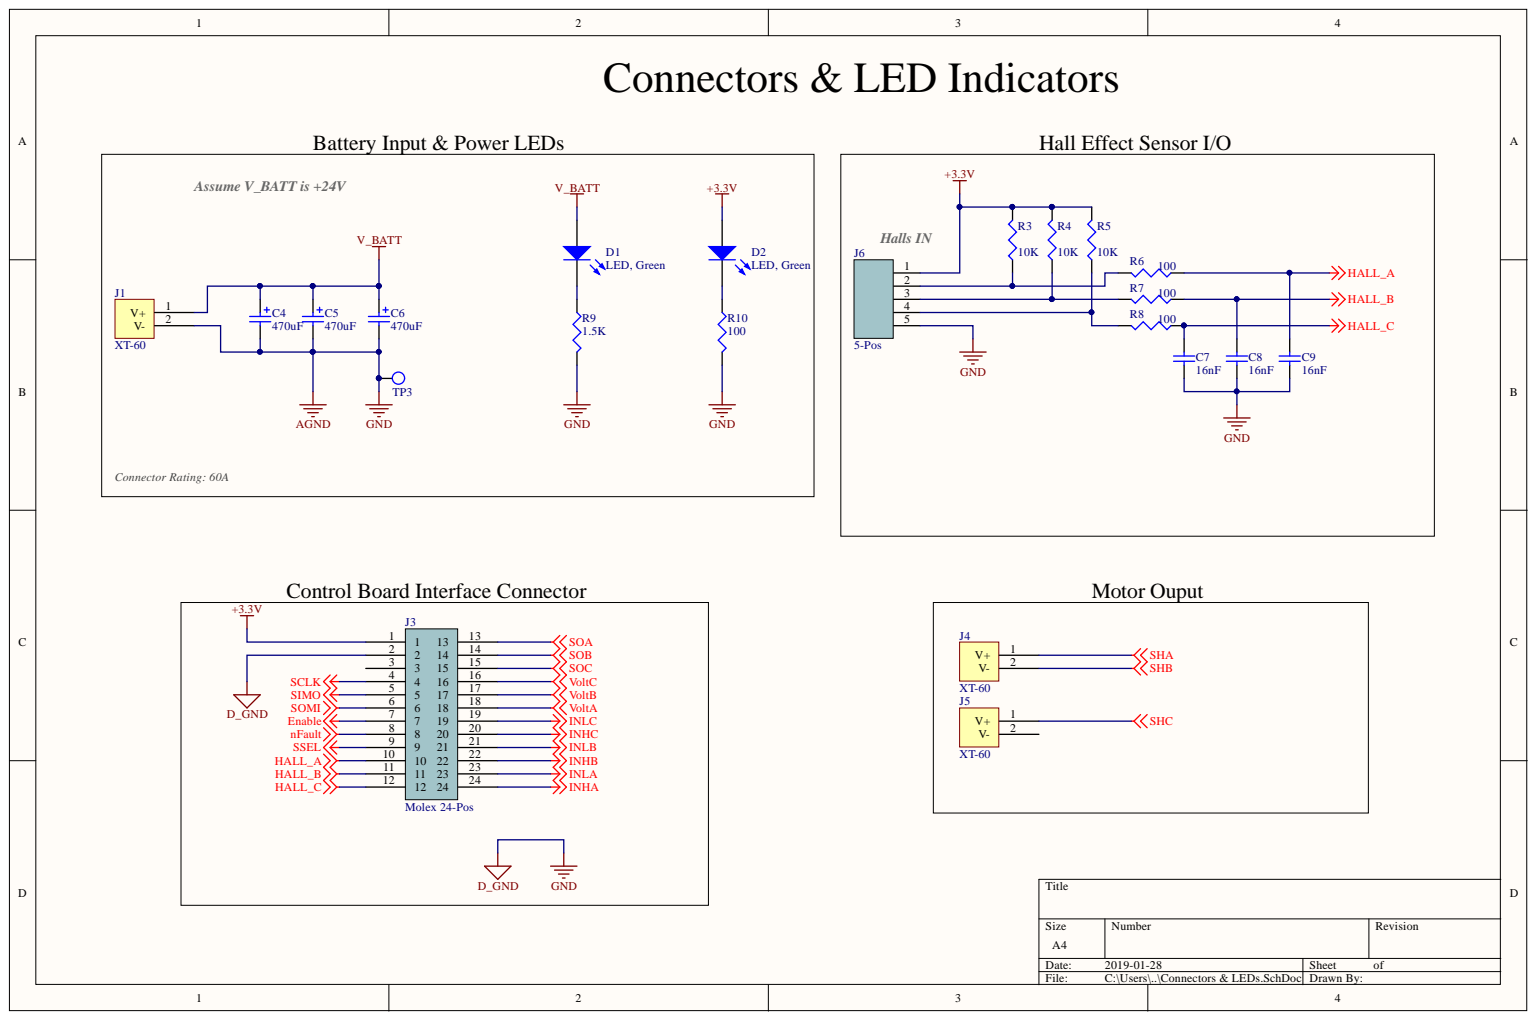
[picture p22: page 2]

ntrol Board Interface Co

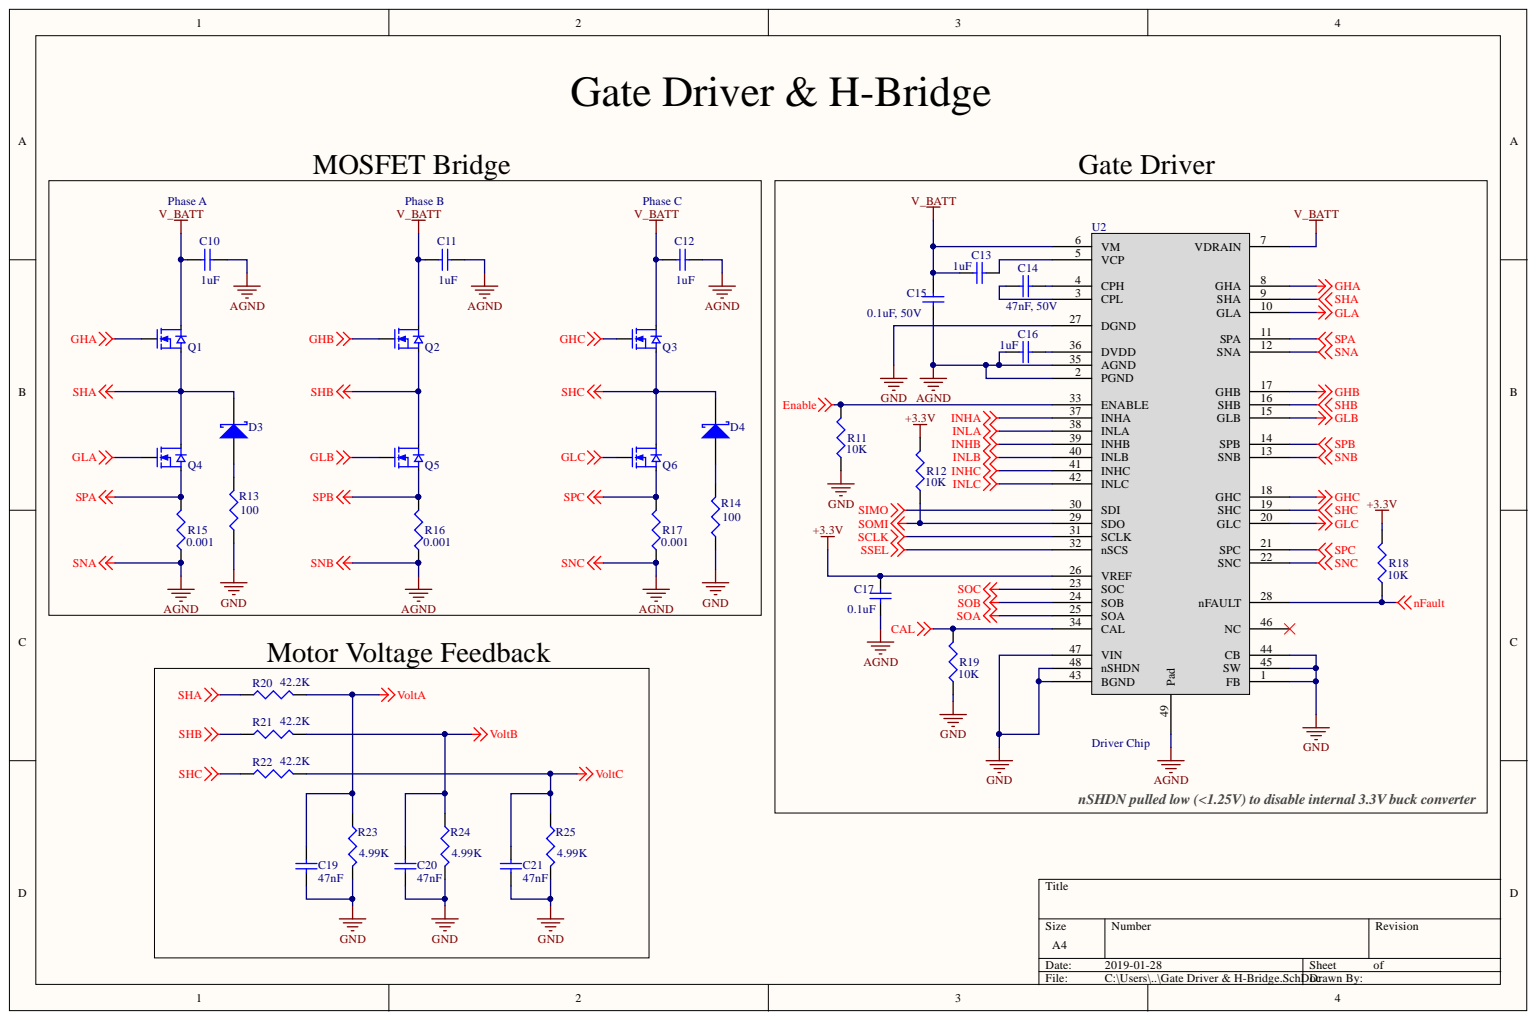
[picture p23: page 3]
