EmbeddedSystemClass/Motor-Driver/2019-2020/Motor Driver Board 2019-2020/Motor Driver Board 2019-2020.pdf

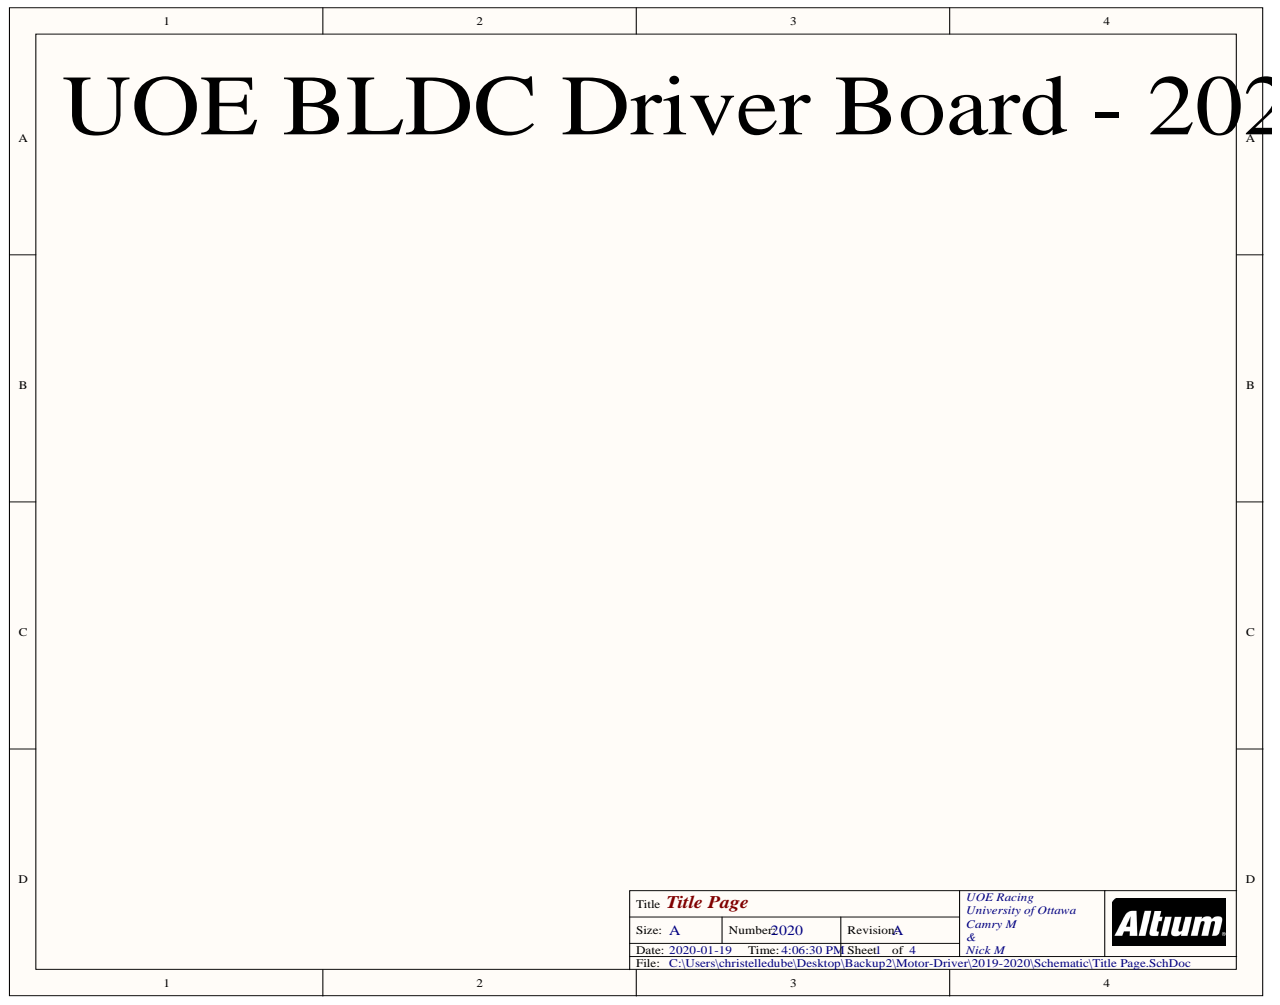
[picture p24: page 1]

UOE BLDC Driver Board - 2020

Title Page Title | UOE Racing University of Ottawa Camry M & Nick M

Size: A | Number: 2020 | Revision: A
Date: 2020-01-19 Time: 4:06:30 PM | | Sheet of 4
File: C:\Users\christelledube\Desktop\Backup2\Motor-Driver\2019-2020\Schematic\Title Page.SchDoc

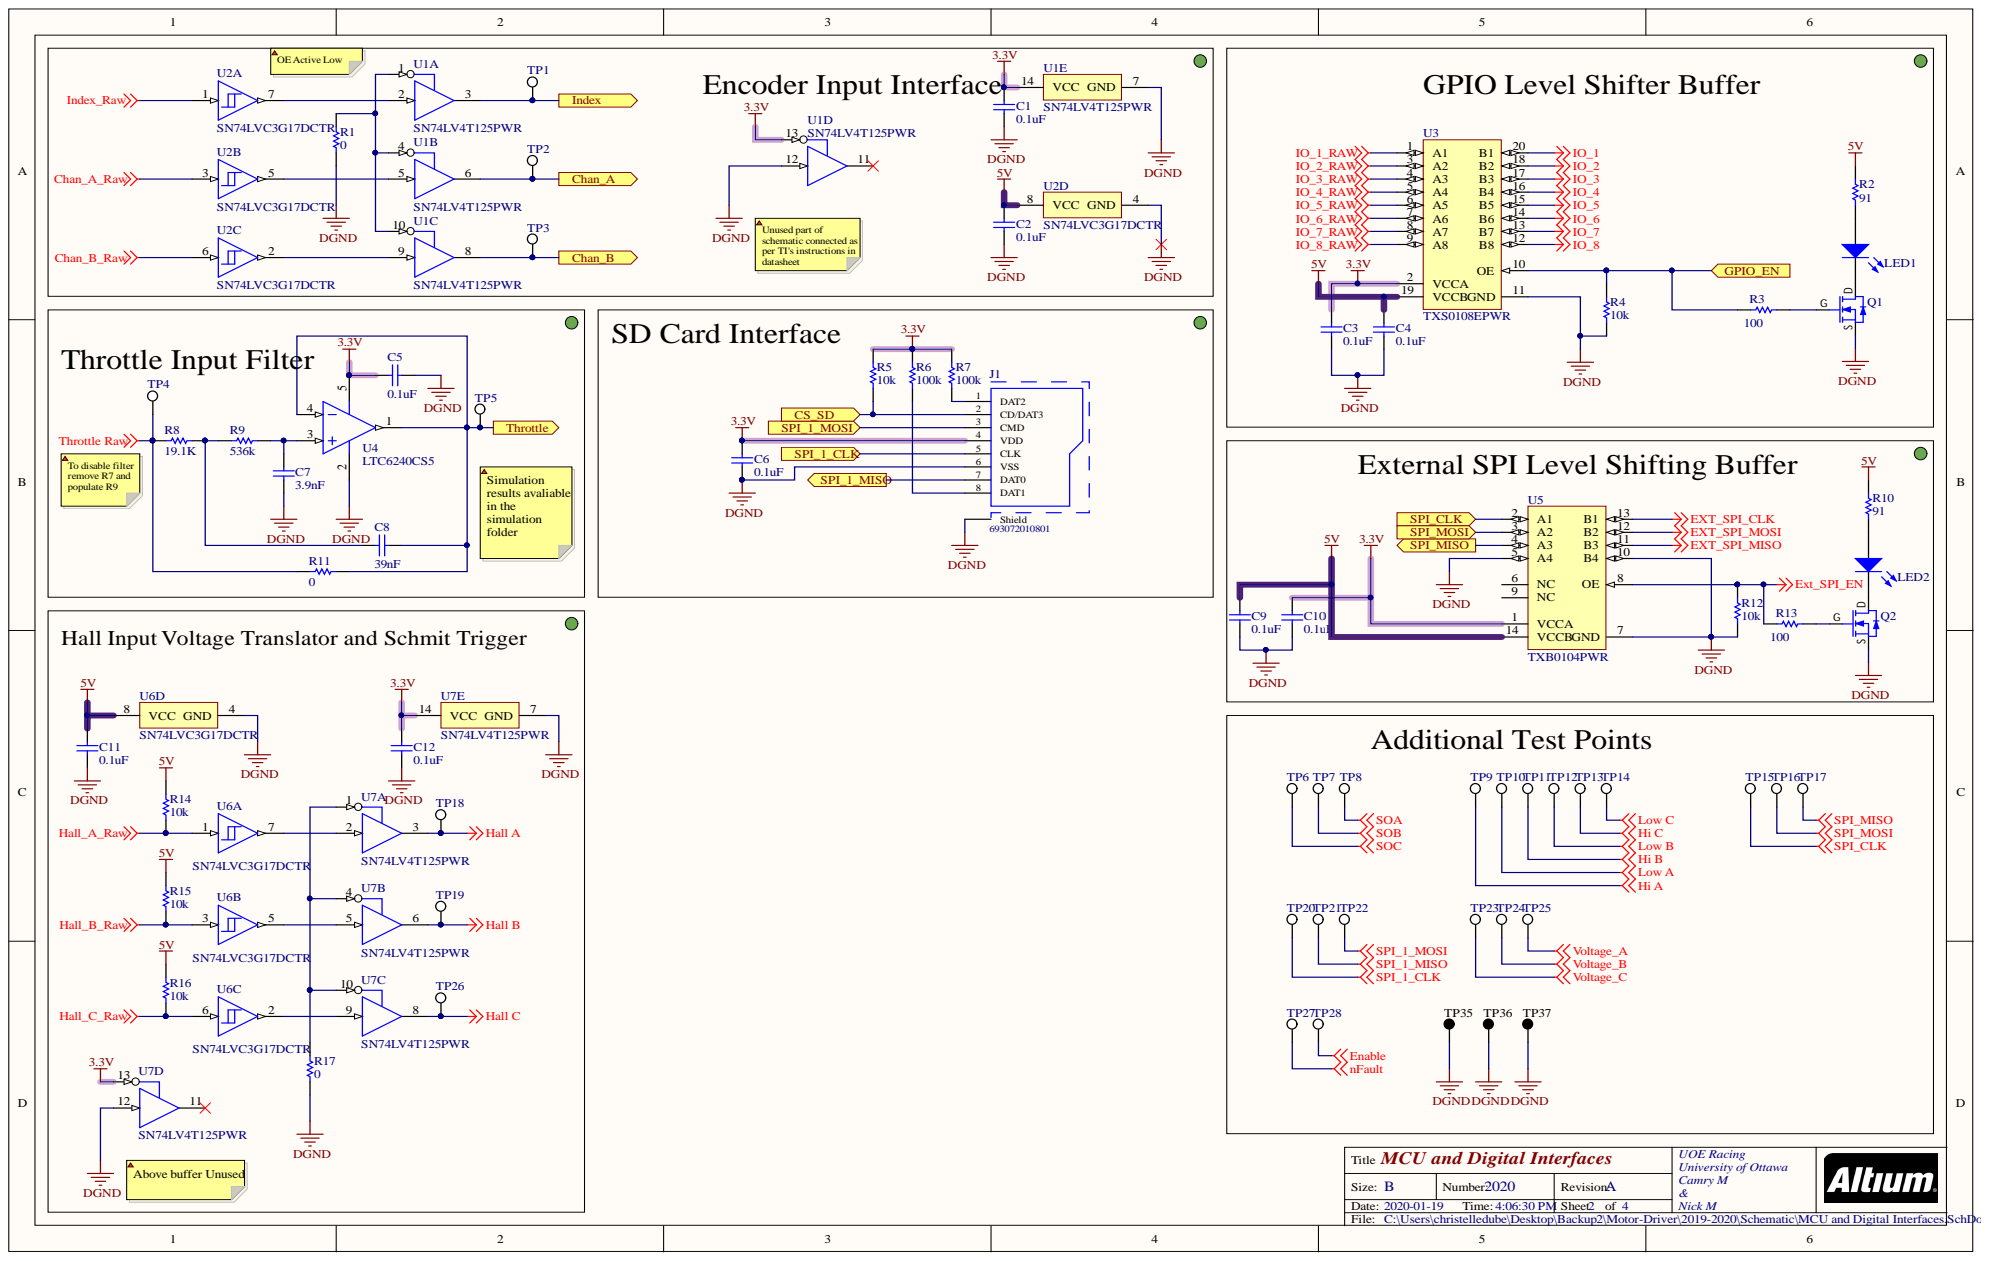
[picture p25: page 2]

GPIO Level Shifter Buffer

Unused part of
schematic connected as
per TI's instructions in
datasheet

0.1uF | | DAT0 7

VSS 6

External SPI Level Shifting Buffer

DAT1 8

Hall Input Voltage Translator and Schmit Trigger

MCU and Digital Interfaces Title | UOE Racing University of Ottawa Camry M & Nick M

Size: B | Number: 2020 | Revision: A
Date: 2020-01-19 Time: 4:06:30 PM | | Sheet 2 of 4

C:\Users\christelledube\Desktop\Backup2\Motor-Driver\2019-2020\Schematic\MCU and Digital Interfaces.SchDoc

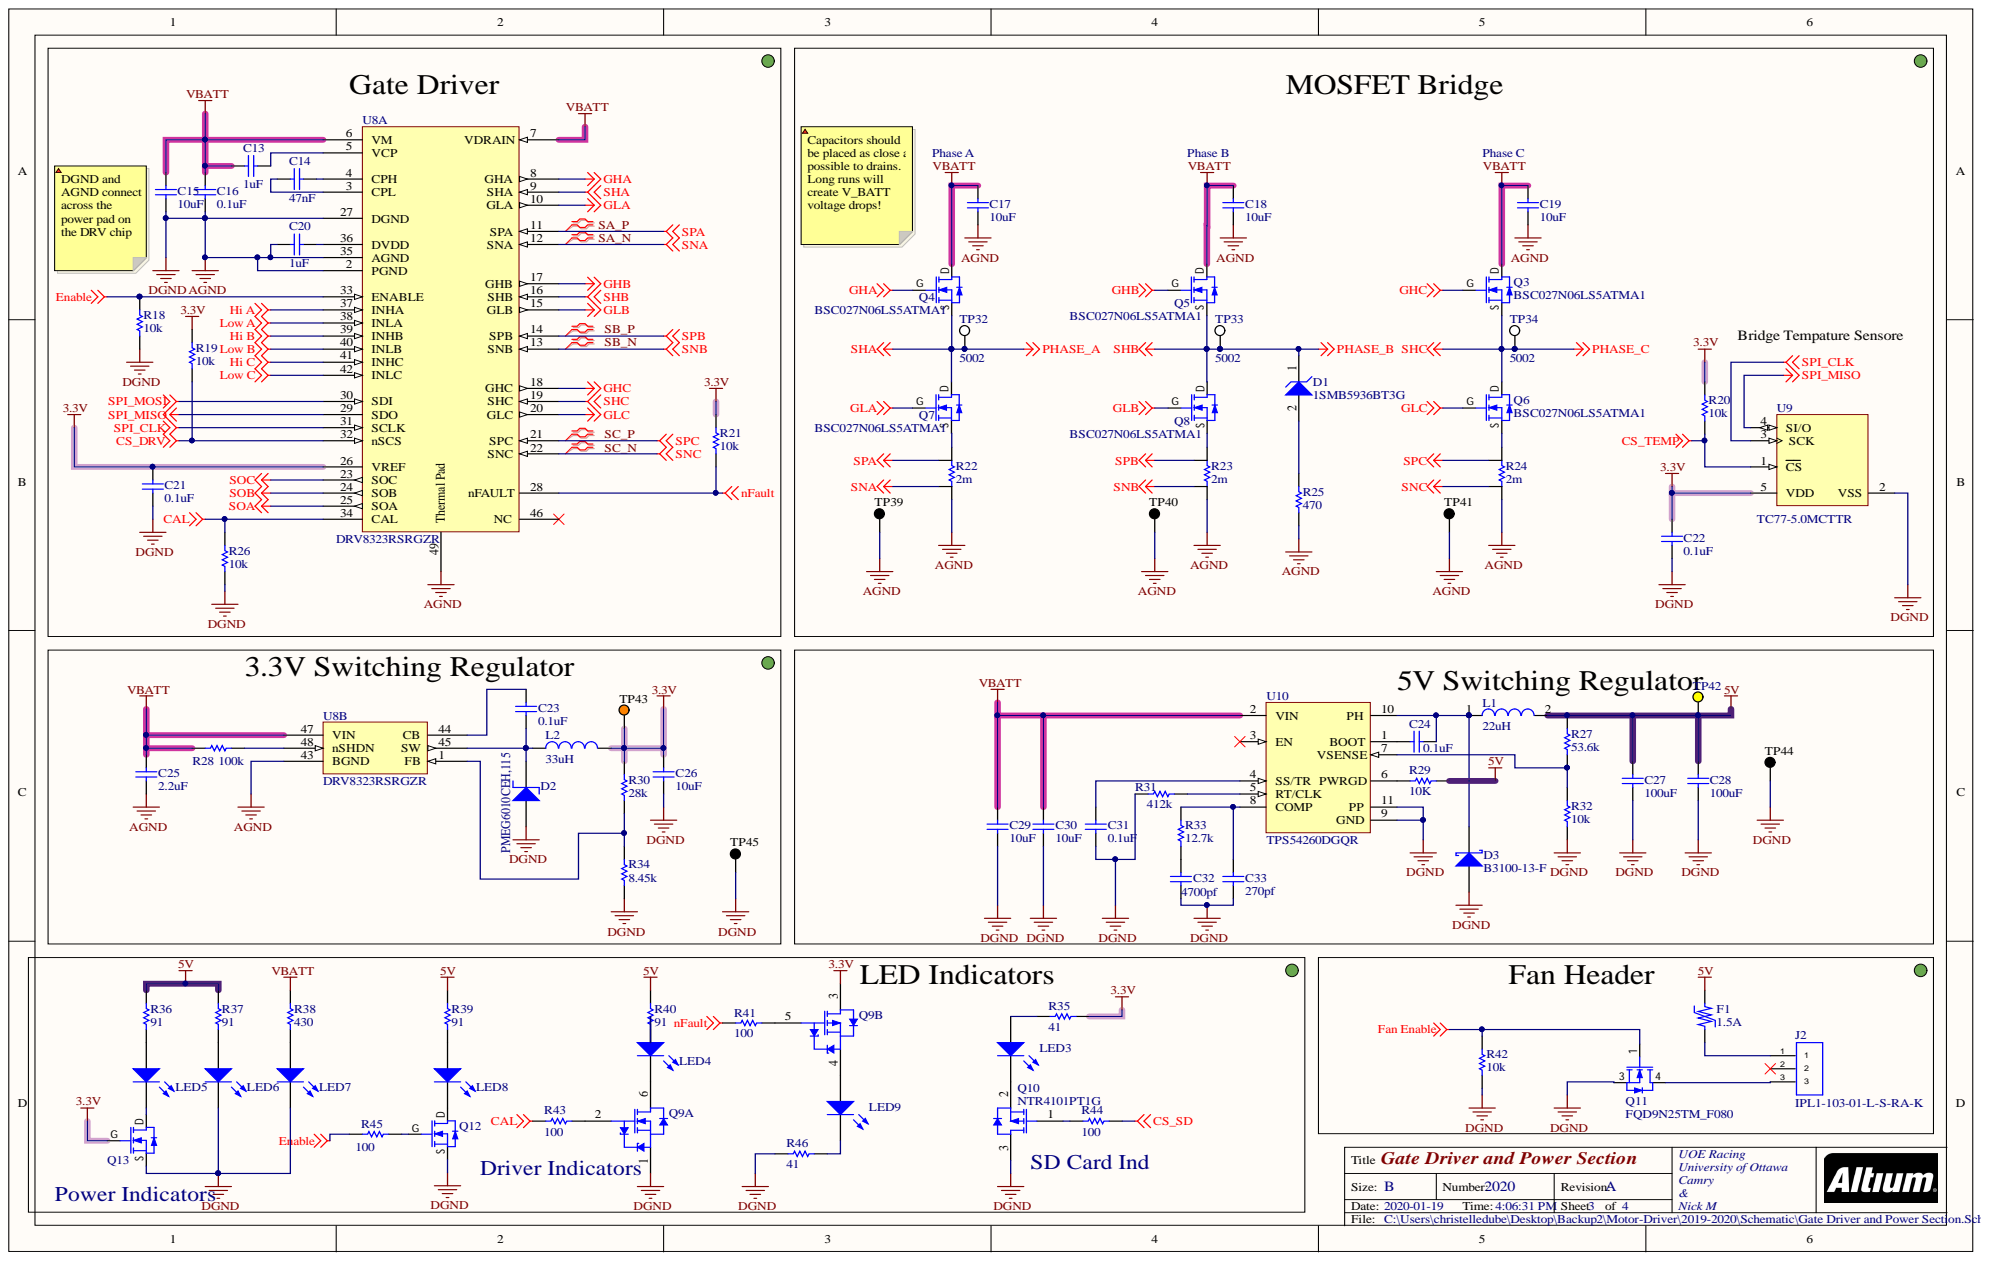
[picture p26: page 3]

Capacitors should
be placed as close a
possible to drains.
Long runs will
create V_BATT
voltage drops!

C20 | DVDD 36

1uF | PGND 2

EN 3
SS/TR 4 | | 0.1uF

BGND 43

R31 | COMP 8

Gate Driver and Power Section
Title

C:\Users\christelledube\Desktop\Backup2\Motor-Driver\2019-2020\Schematic\Gate Driver and Power Section.SchDoc

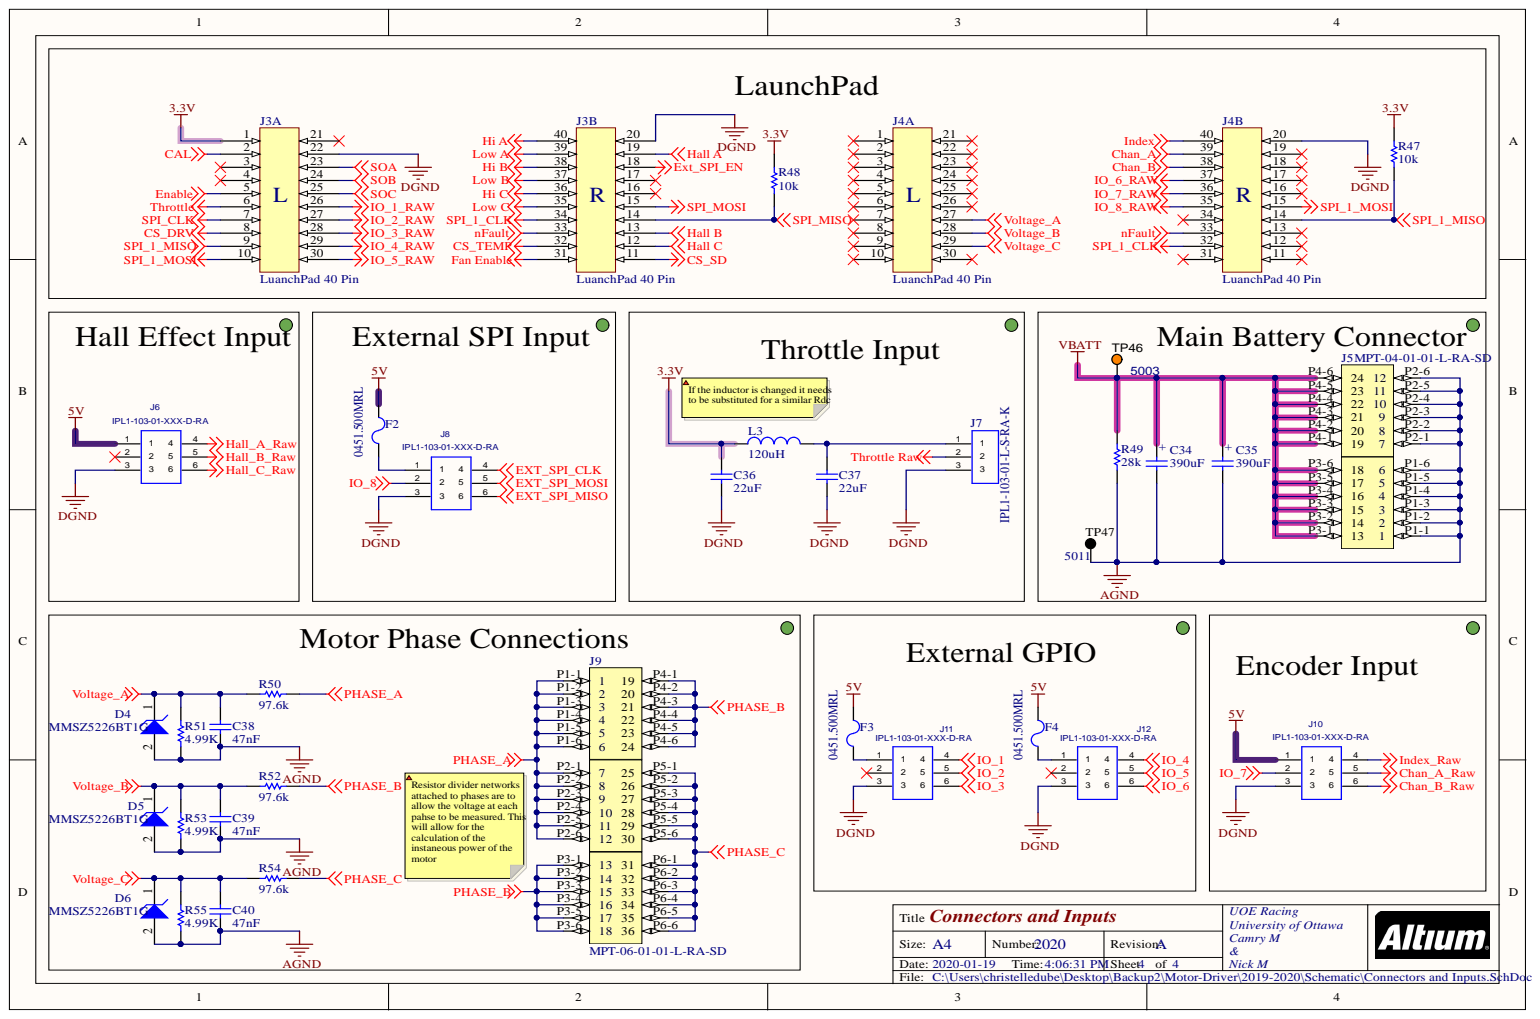
[picture p27: page 4]

If the inductor is changed it needs
to be substituted for a similar Rdc

Resistor divider networks
attached to phases are to
allow the voltage at each
pahse to be measured. This
will allow for the
calculation of the
instaneous power of the
motor

C:\Users\christelledube\Desktop\Backup2\Motor-Driver\2019-2020\Schematic\Connectors and Inputs.SchDoc

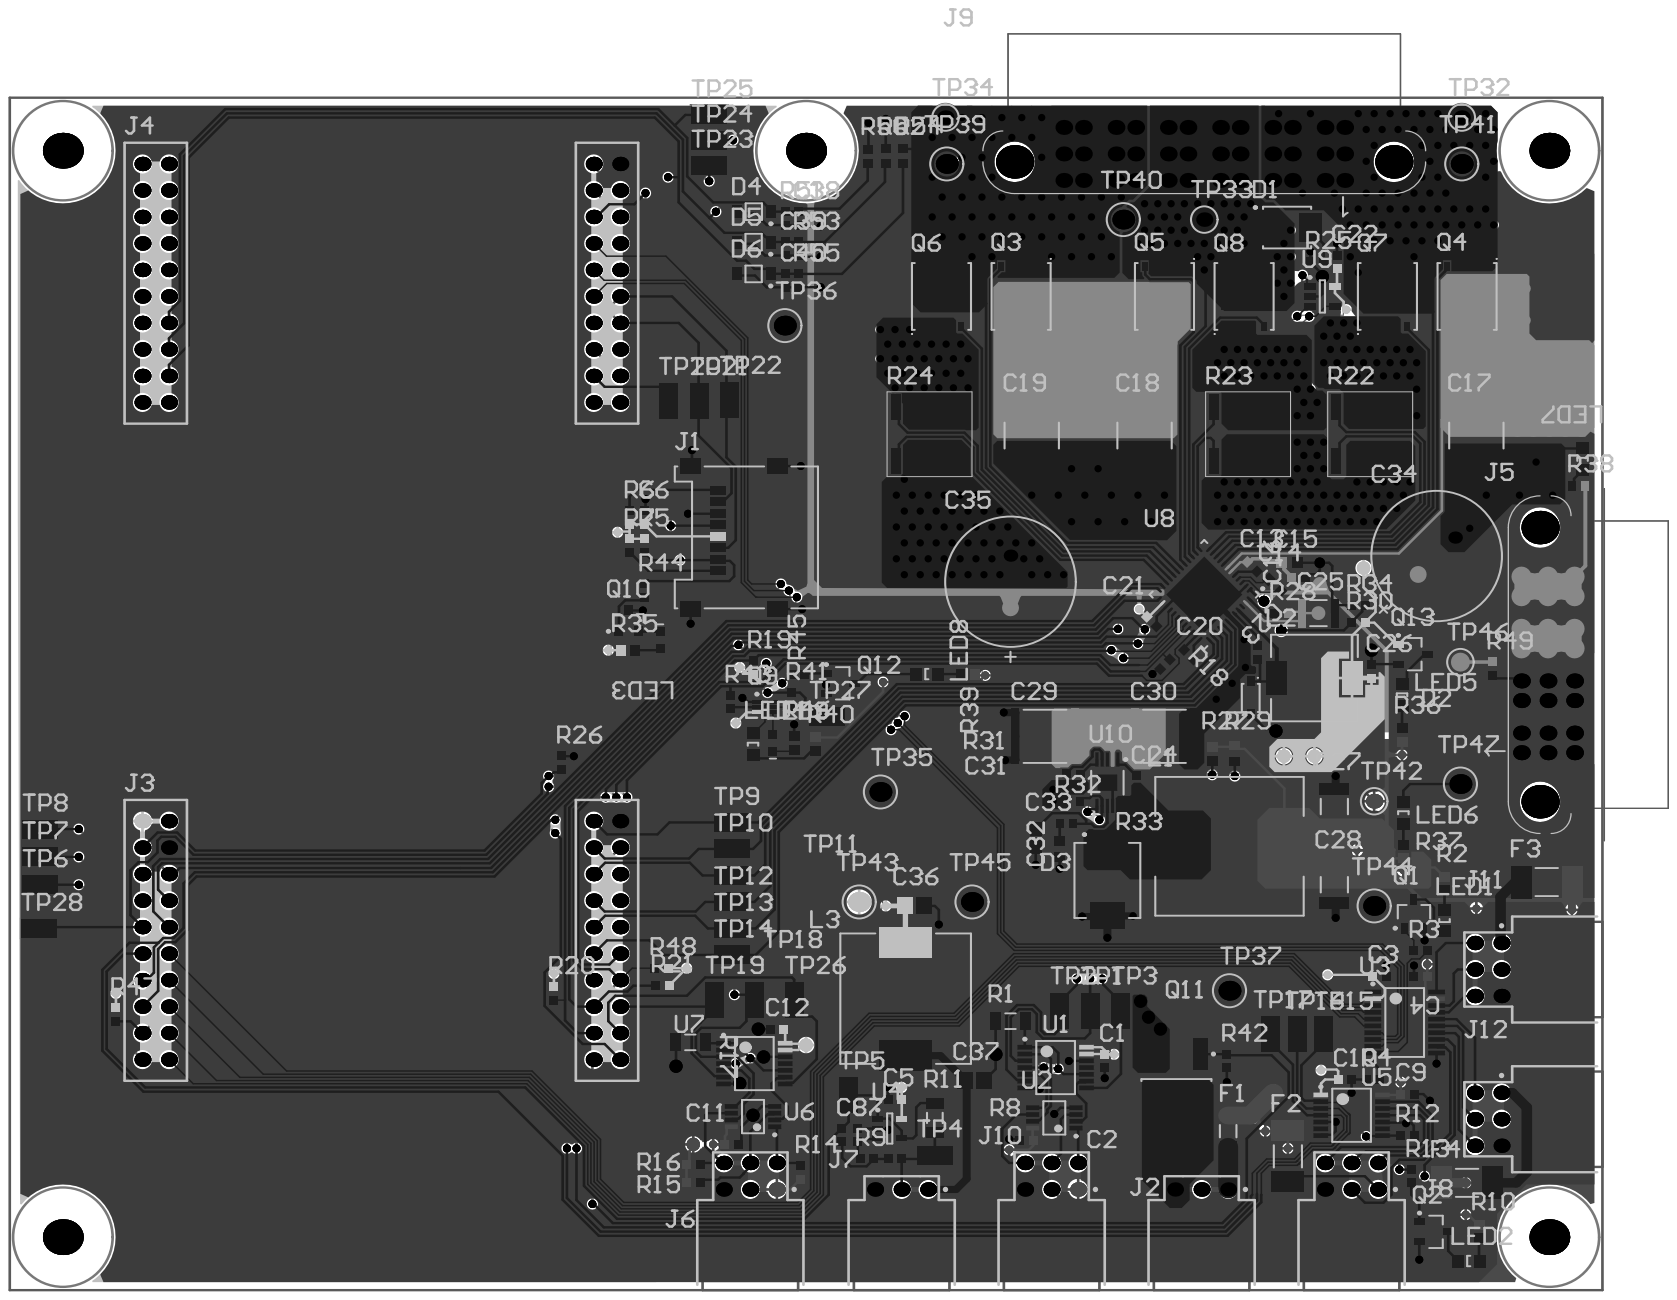
[picture p28: page 5]
