EmbeddedSystemClass/Motor-Driver/2019-2020/Motor Driver Board 2019-2020/Motor Driver Board 2019-2020 pdf2.pdf

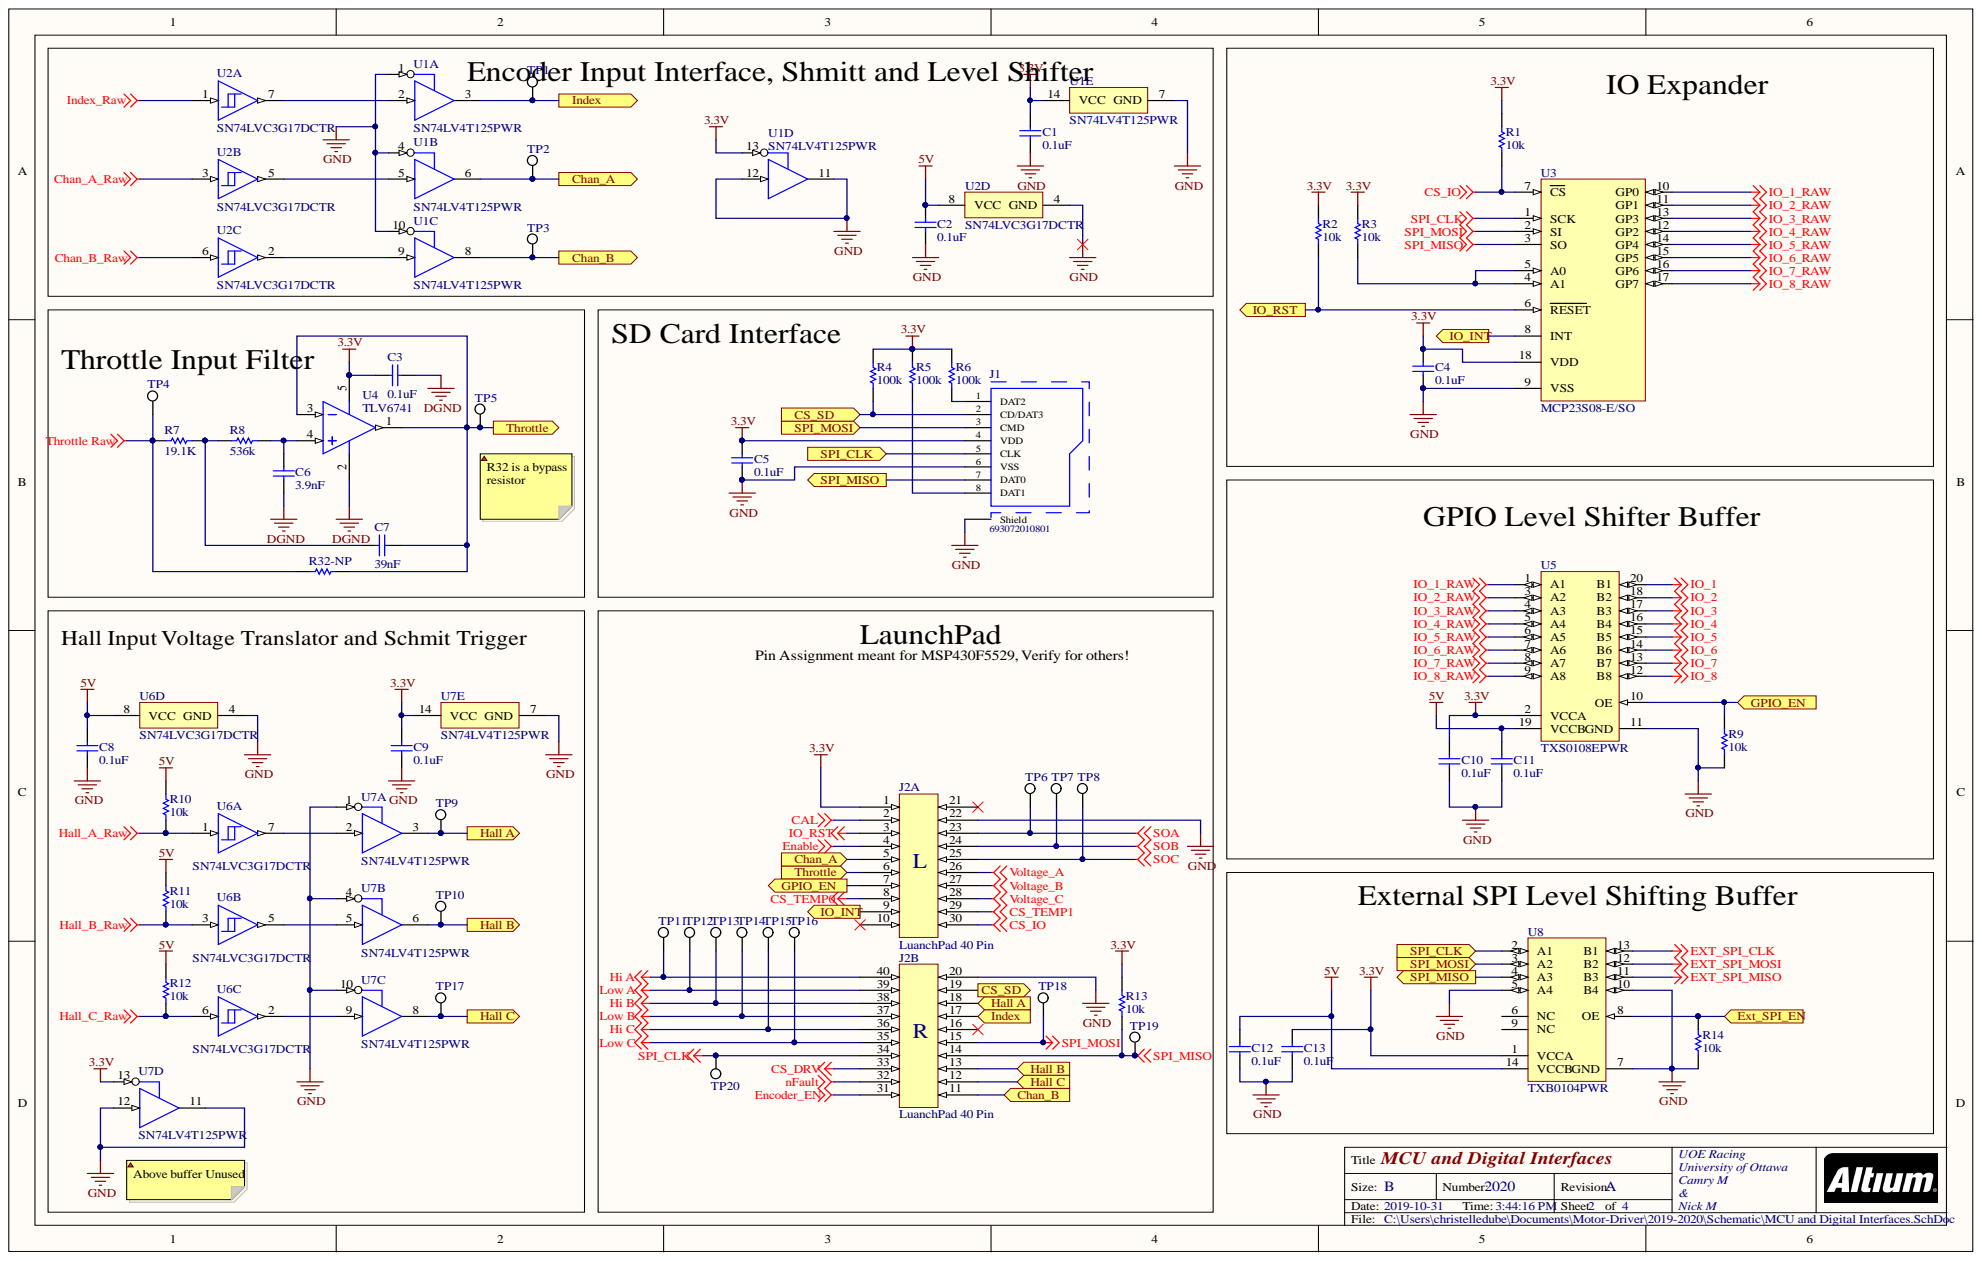
[picture p29: page 1]

Encoder Input Interface, Shmitt and Level Shifter

GPIO Level Shifter Buffer

Hall Input Voltage Translator and Schmit Trigger

Pin Assignment meant for MSP430F5529, Verify for others!

External SPI Level Shifting Buffer TP11TP12TP13TP14TP15TP16

MCU and Digital Interfaces Title | UOE Racing University of Ottawa Camry M & Nick M

Size: B | Number: 2020 | Revision: A
Date: 2019-10-31 Time: 3:44:16 PM | | Sheet 2 of 4

C:\Users\christelledube\Documents\Motor-Driver\2019-2020\Schematic\MCU and Digital Interfaces.SchDoc

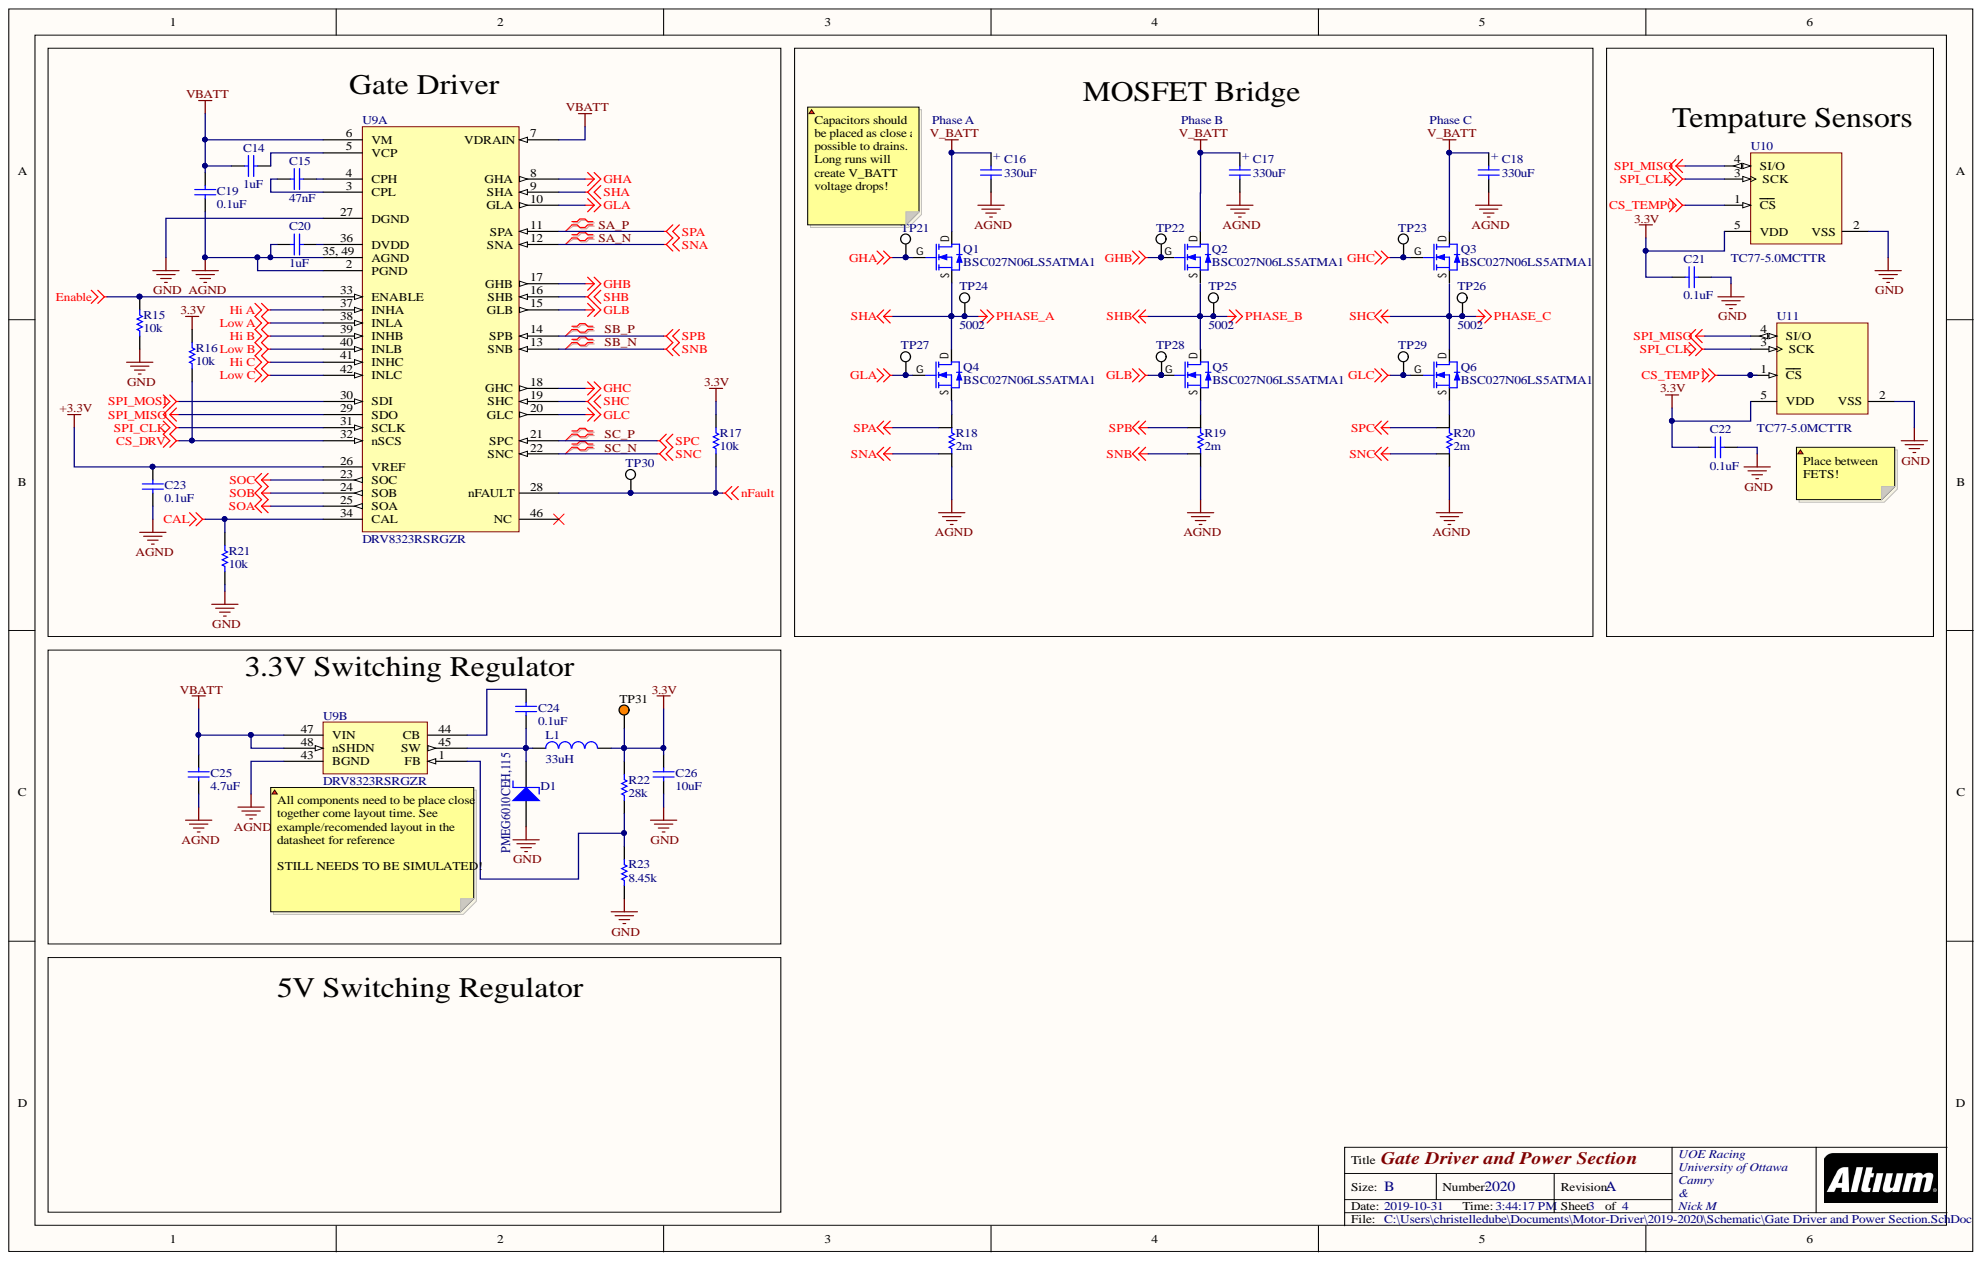
[picture p30: page 2]

GLA SHA SPA SNA

GLB SHB SPB SNB

GLC SHC SPC SNC

G a te Driver and Po wer Sect i o n | UOE Ra cin g Univ ersity of Ottawa Camry & Nic k M

B | mb er: 2 0 2 0 | Re visio n A :

Date : 2 0 1 9-1 0-3 1 Tim e : 3:4 4:1 7 P M | | S h e e t 3 o f 4

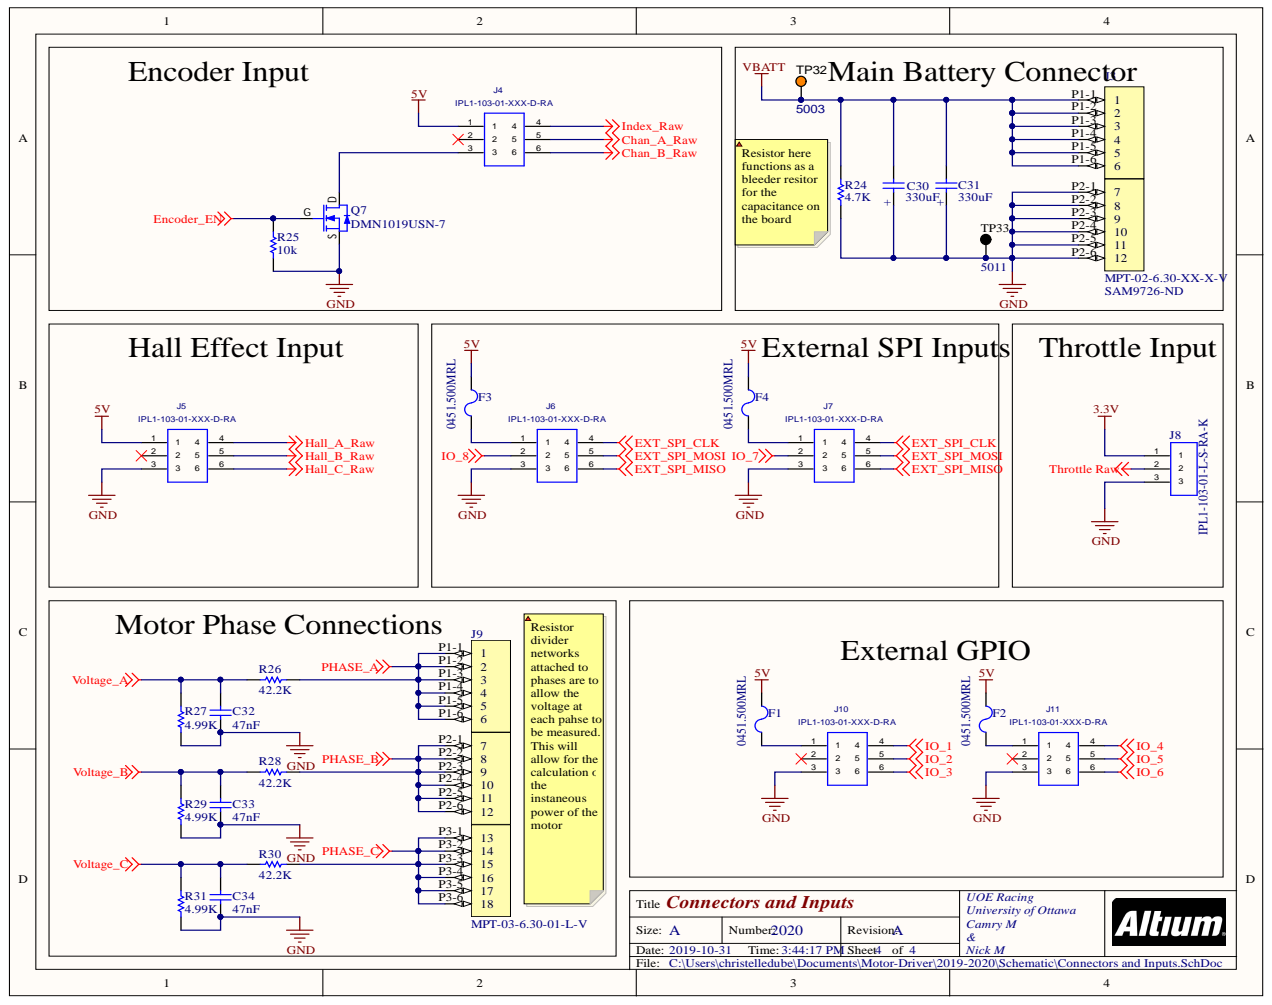
[picture p31: page 3]

Main Battery Connector VBATT

C:\Users\christelledube\Documents\Motor-Driver\2019-2020\Schematic\Connectors and Inputs.SchDoc

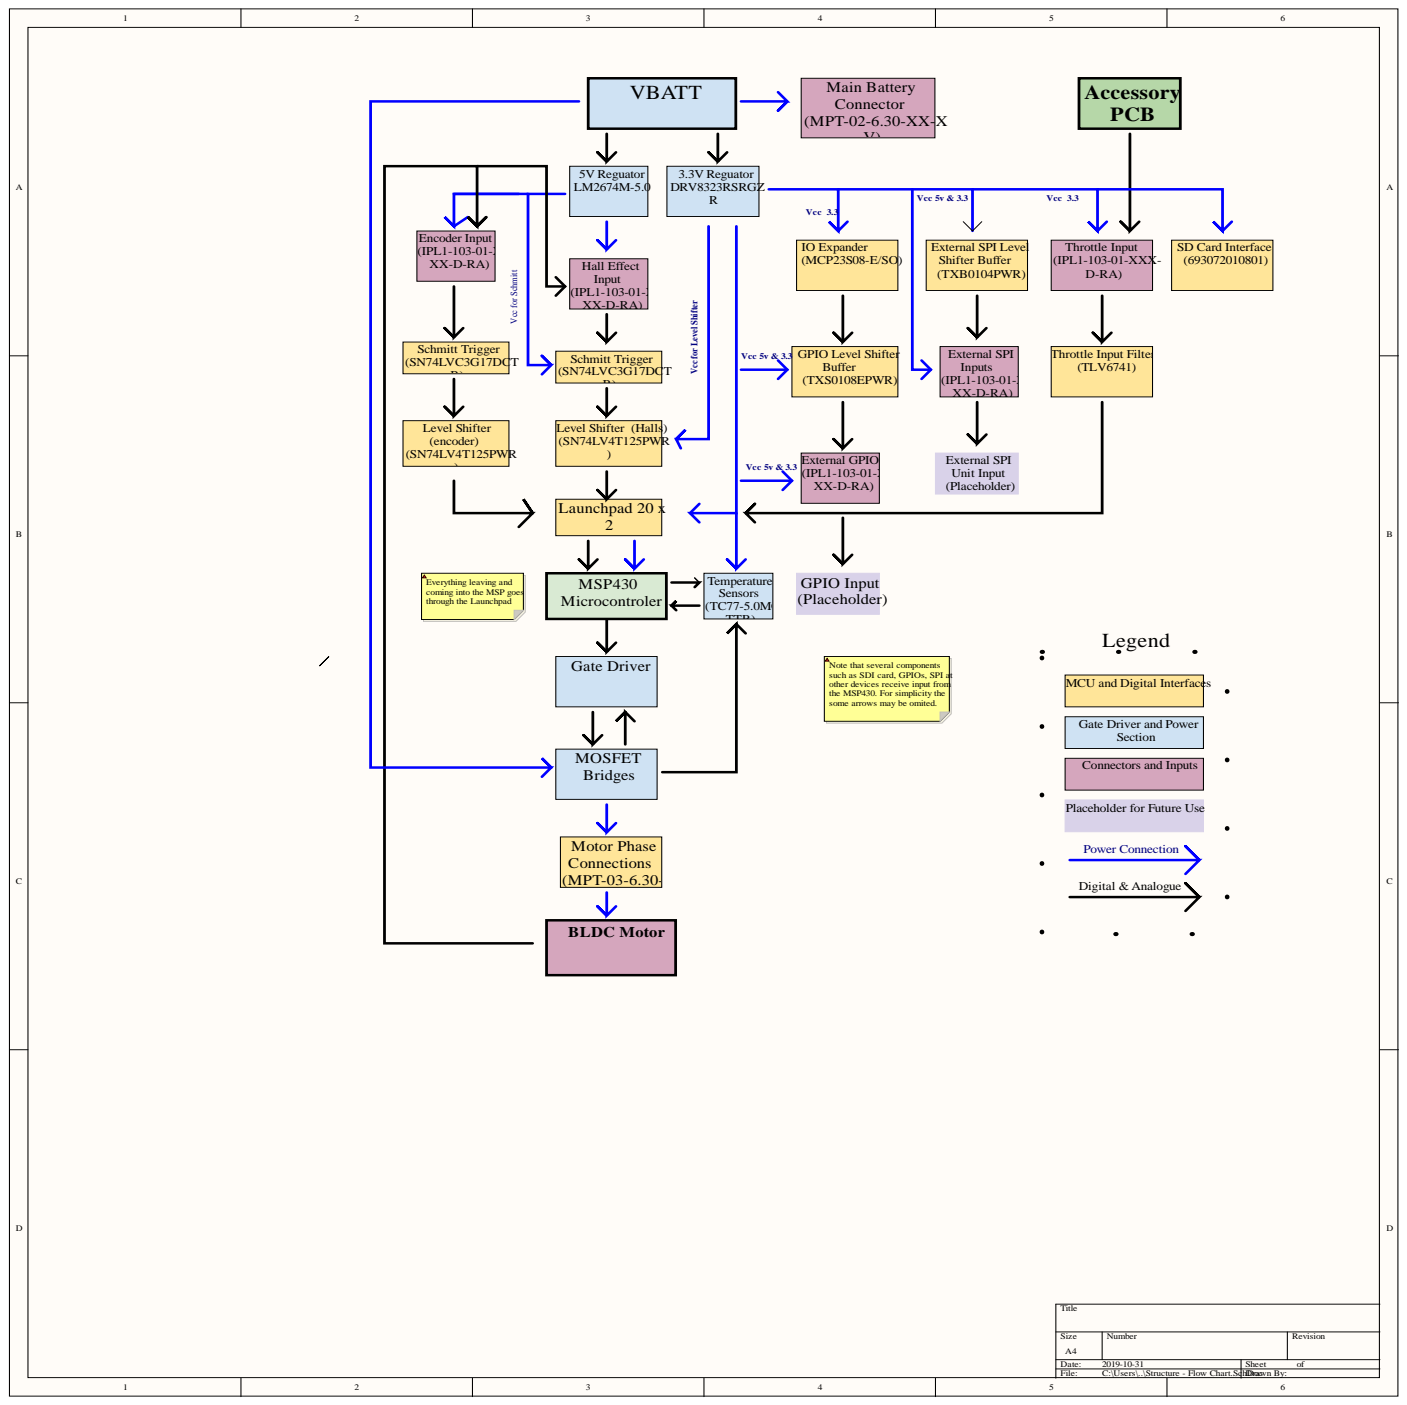
[picture p32: page 4]

Vcc | 5v & 3.3

Encoder Input (IPL1-103-01-X XX-D-RA)

Vcc for Level Shifter

Everything leaving and
coming into the MSP goes
through the Launchpad

Note that several components
such as SDI card, GPIOs, SPI at
other devices receive input from
the MSP430. For simplicity the
some arrows may be omited.

MCU and Digital Interfaces

Gate Driver and Power

Placeholder for Future Use

Size A4 | Number | Revision

Date: 2019-10-31 | Sheet of
File: C:\Users\..\Structure - Flow Chart.SchDDraocwn By:

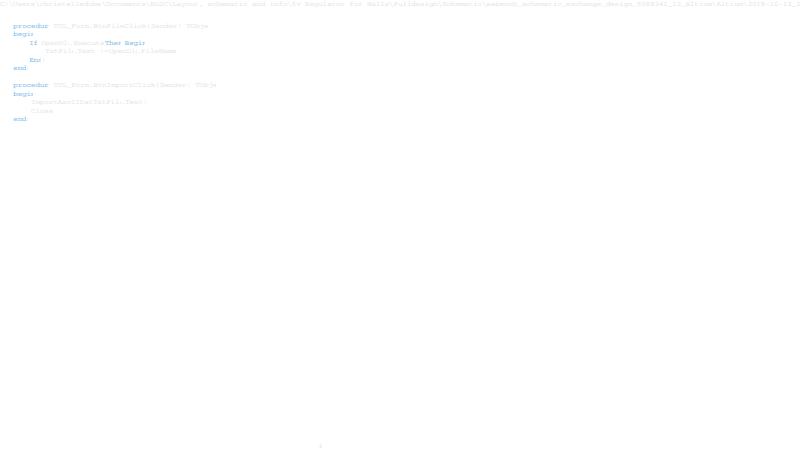
[picture p33: page 5]

C:\Users\christelledube\Documents\BLDC\Layout, schematic and info\5v Regulator for Halls\Fulldesign\Schematic\webench_schematic_exchange_design_6088341_12_Altium\Altium\2019-10-12_17

procedureTUL_Form.BtnFileClick(Sender: TObje
begin
If OpenDlg.ExecuteThen Begin
TxtFile.Text :=OpenDlg.FileName
End;
end;
