EmbeddedSystemClass/Motor-Driver/2019-2020/Simulations/3.3V Power filter/Ac Sweep.pdf

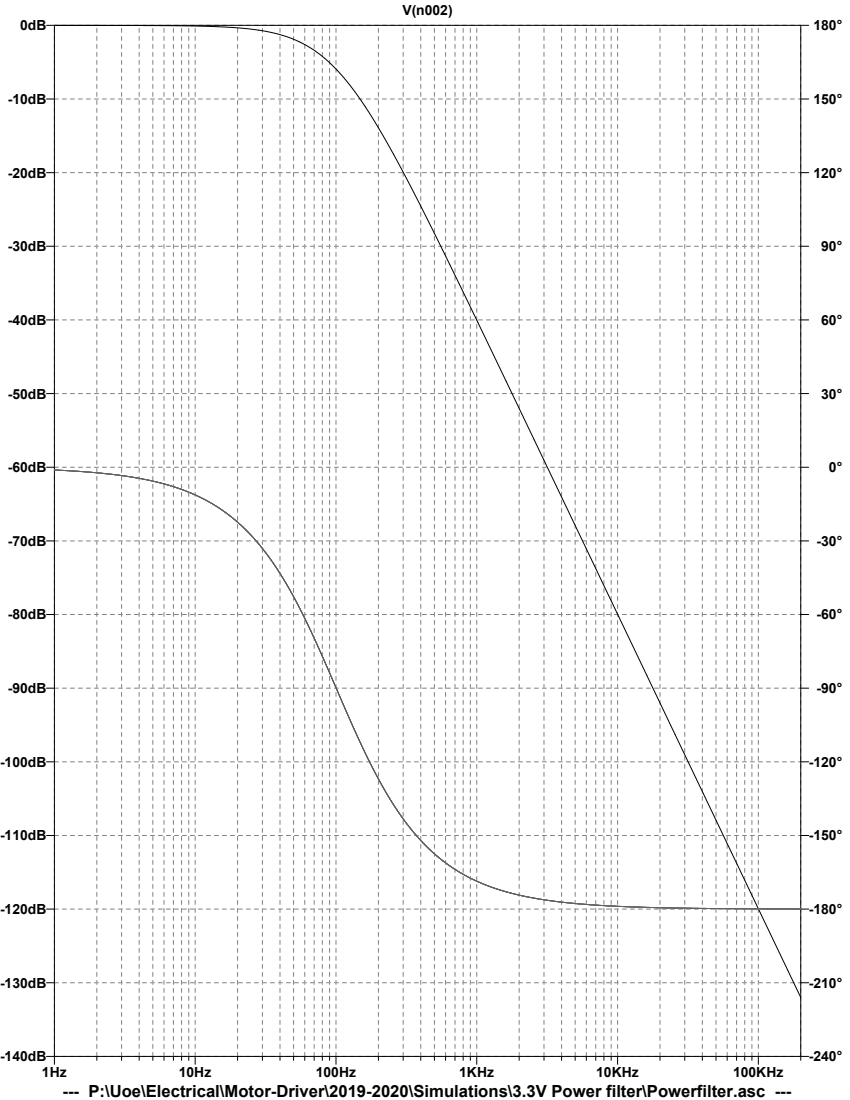
[picture p34: page 1]
1KHz; 10KHz; 100KHz

--- P:\Uoe\Electrical\Motor-Driver\2019-2020\Simulations\3.3V Power filter\Powerfilter.asc ---
