EmbeddedSystemClass/Motor-Driver/2019-2020/Simulations/Motor Voltage Feedback/Ac Sweep.pdf

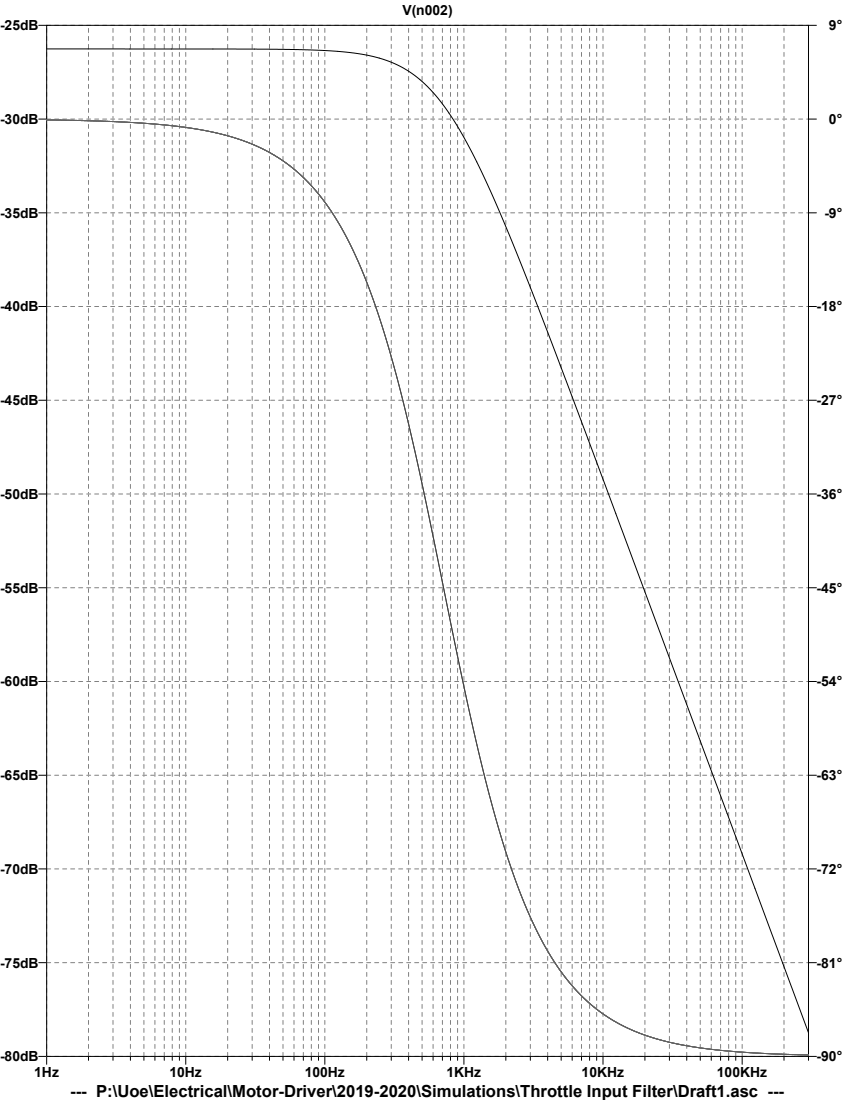
[picture p35: page 1]
1KHz; 10KHz; 100KHz

--- P:\Uoe\Electrical\Motor-Driver\2019-2020\Simulations\Throttle Input Filter\Draft1.asc ---
