EmbeddedSystemClass/Motor-Driver/2019-2020/Simulations/Motor Voltage Feedback/DC Sweep.pdf

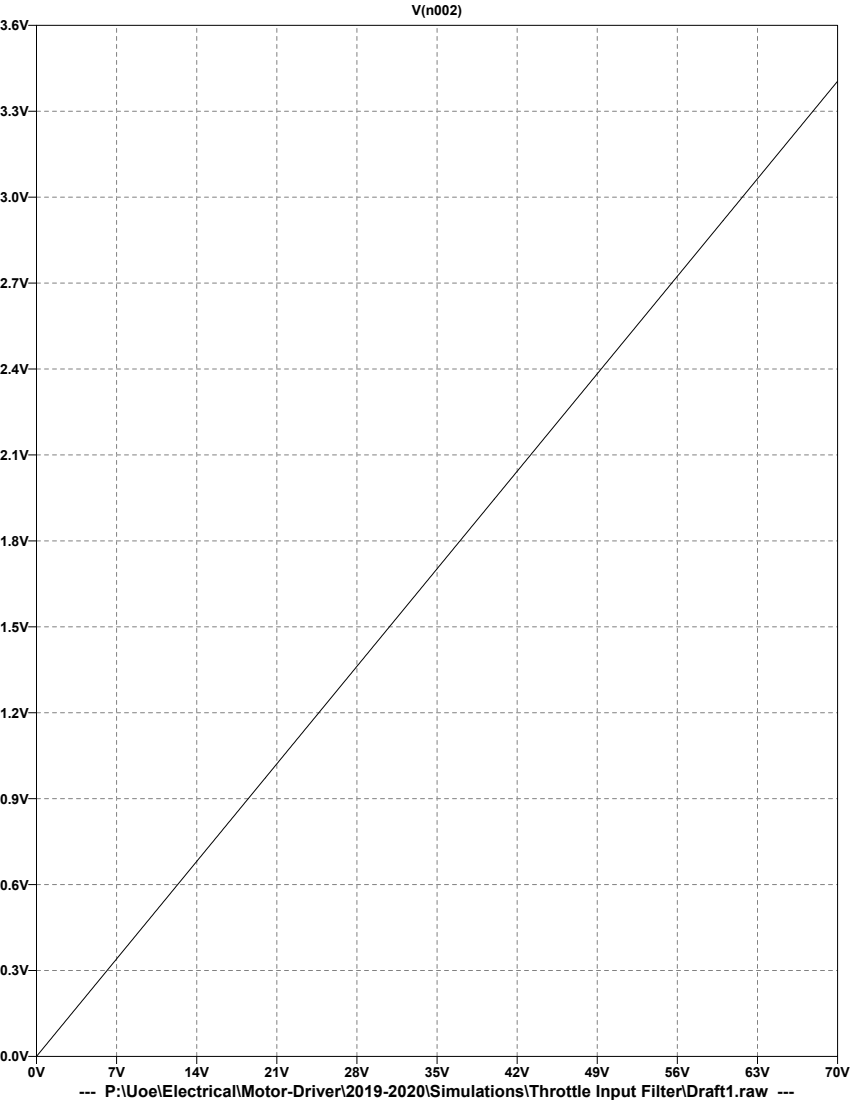
[picture p36: page 1]

--- P:\Uoe\Electrical\Motor-Driver\2019-2020\Simulations\Throttle Input Filter\Draft1.raw ---
