EmbeddedSystemClass/Motor-Driver/2019-2020/Simulations/Throttle Input Filter/DC Sweep.pdf

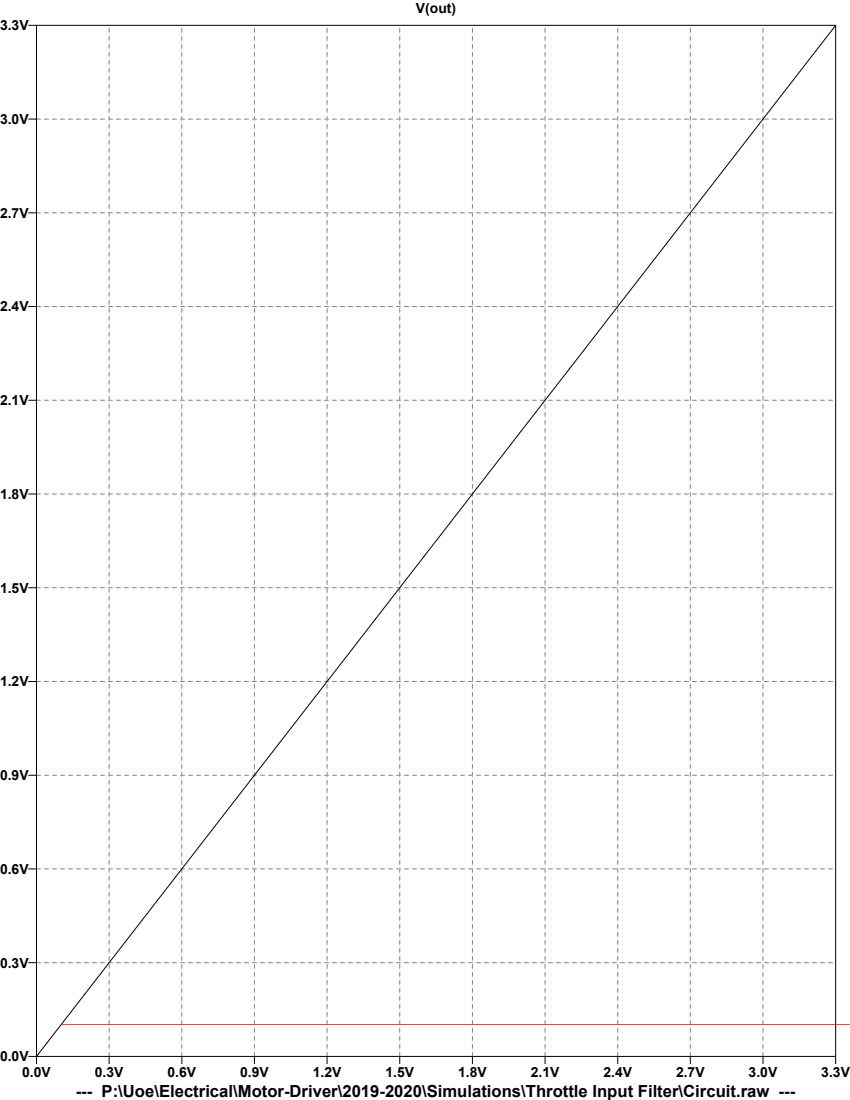
[picture p37: page 1]
V(out)

--- P:\Uoe\Electrical\Motor-Driver\2019-2020\Simulations\Throttle Input Filter\Circuit.raw ---
