EmbeddedSystemClass/Motor-Driver/2019-2020/Simulations/Throttle Input Filter/Frequency Sweep.pdf

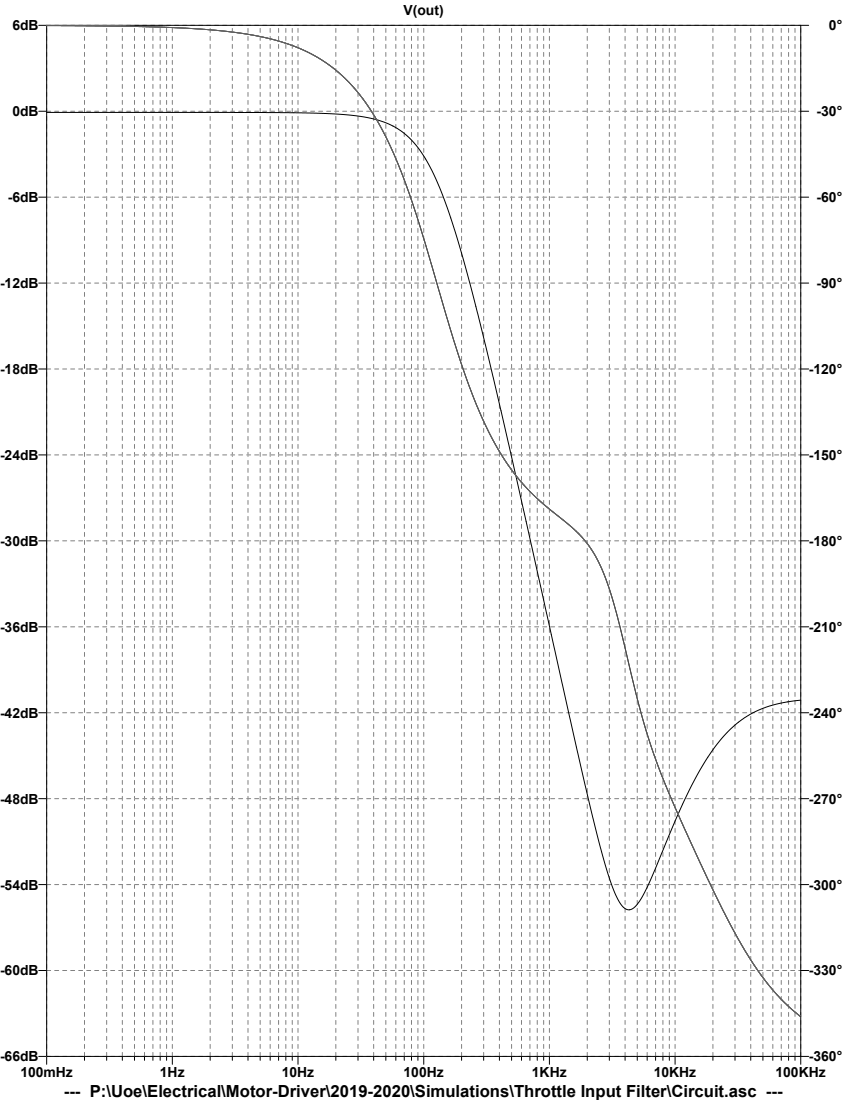
[picture p38: page 1]
100mHz; 1KHz; 10KHz; 100KHz; V(out)

--- P:\Uoe\Electrical\Motor-Driver\2019-2020\Simulations\Throttle Input Filter\Circuit.asc ---
