EmbeddedSystemClass/Motor-Driver/Part Libraries/ECAR_Refrence_Libary/OTHER/SW3639/_schematics_NTAG I2C plus Class4 Antenna v1.pdf

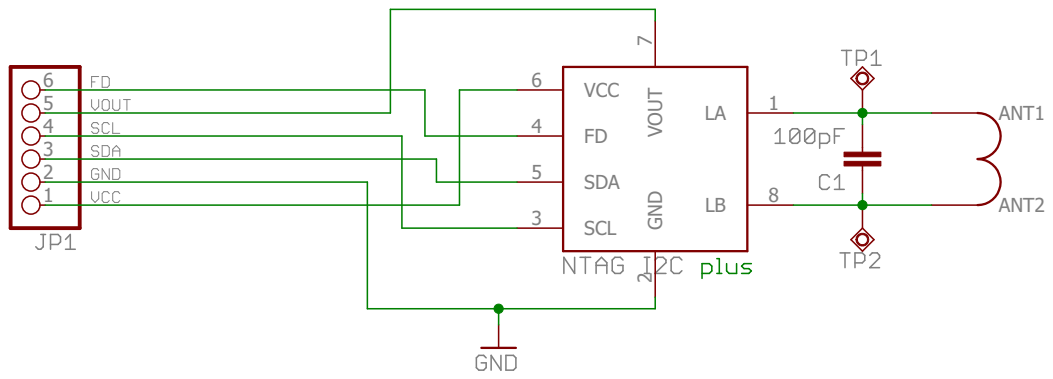
[picture p39: page 1]
