EmbeddedSystemClass/Motor-Driver/2019-2020/Simulations/5V Power Regulator/Power Regulator.asc

C1: cap; 2.2µ
C2: cap; 4.7µ
C3: cap; 4.7µ
C4: cap; 0.1µ
C5: cap; 470n
C6: cap; 47p
C7: cap; 100µ
C8: cap; 100µ
L1: ind; 15µ; Rser=27m
R1: res; 88.7k
R2: res; 22.1k
R3: res; 2.5
U1: LMR23630_TRANS; MODE=1
V1: voltage; 28; Rser=0.01
Named nets: 0, Vin, SW, RT, Boot, FB
.tran 0 500m 0 10u startup
