EmbeddedSystemClass/Motor-Driver/2019-2020/Simulations/5V Power Regulator/Powerfilter.asc

C1: cap; 21µ.µ
C2: cap; 21.1µ
L1: ind; 120m; Ipk=0.069 Rser=150
R1: res; 100k
V1: voltage; 3.3; AC 1
Named nets: 0
.ac dec 1000 1 200k
;.tran 0 10m 0 10u
