EmbeddedSystemClass/Motor-Driver/2019-2020/Simulations/Motor Voltage Feedback/Motor Voltage Feedback.asc

C1: cap; 47n
R1: res; 97.6k
R2: res; 4.99k; tol=1
V1: voltage; ""; AC 1
Named nets: 0
;.ac dec 1000 1 300k
.dc V1 0 70 0.1
