EmbeddedSystemClass/Motor-Driver/2019-2020/Simulations/Throttle Input Filter/Circuit.asc

C1: cap; 39n
C2: cap; 3.9n
R1: res; 536k
R2: res; 19.1k
U1: LTC6240
V1: voltage; 3.3; AC 1
V2: voltage; 3.3
Named nets: 0, Out
.ac dec 1k 100m 100k
;tran 0 100m 0 1m
;.dc V1 0 3.3 1m
