EmbeddedSystemClass/Motor-Driver/(list of files, drawings)

Other design files:
2018-19/3.3V Regulator.SchDoc
2018-19/Connectors & LEDs.SchDoc
2018-19/ECAR_PARTS.PcbLib
2018-19/EReference-PCB.PcbLib
2018-19/Gate Driver & H-Bridge.SchDoc
2018-19/MOSFET Board Layout.PcbDoc
2018-19/MOSFET Board Project.PrjPCB
2018-19/MOSFET Board Schematic Library.SchLib
2018-19/MOSFET Board Schematics 2.SchDoc
2018-19/MOSFET Board Schematics.SchDoc
2018-19/Sheet1.SchDoc
2018-19/UOE MOSFET Board Footprints.PcbLib
2019-2020/Board/Power_Board_Layout_V2.PcbDoc
2019-2020/Motor Driver Board 2019-2020/Motor Driver Board 2019-2020.PrjPcb
2019-2020/Motor Driver Board 2019-2020/Motor Driver Board 2019-2020/BLDC-2020.PcbLib
2019-2020/Motor Driver Board 2019-2020/Motor Driver Board 2019-2020/Motor Driver Board 2019-2020.SCHLIB
2019-2020/Motor Driver Board 2019-2020/Motor Driver Board 2019-20201/BLDC-2020.PcbLib
2019-2020/Motor Driver Board 2019-2020/Motor Driver Board 2019-20201/Motor Driver Board 2019-2020.SCHLIB
2019-2020/Motor Driver Board 2019-2020/Old/Power_Board_Layout_V2.PcbDoc
2019-2020/Motor Driver Board 2019-2020/Structure - Flow Chart.SchDoc
2019-2020/PCB/BLDC-2020_BASE_2544.PcbDoc
2019-2020/PCB/BLDC-2020_REMOTE_2544.PcbDoc
2019-2020/Schematic/Connectors and Inputs.SchDoc
2019-2020/Schematic/Gate Driver and Power Section.SchDoc
2019-2020/Schematic/MCU and Digital Interfaces.SchDoc
2019-2020/Schematic/Old/3.3V Regulator.SchDoc
2019-2020/Schematic/Old/Connectors & LEDs.SchDoc
2019-2020/Schematic/Old/Gate Driver & H-Bridge.SchDoc
2019-2020/Schematic/Protection and Test Points.SchDoc
2019-2020/Schematic/Title Page.SchDoc
Part Libraries/ECAR_Refrence_Libary/EReference-PCB.PcbLib
Part Libraries/ECAR_Refrence_Libary/EReference-Schematic.SchLib
Part Libraries/ECAR_Refrence_Libary/OTHER/Imported MPT-04-01-XX-X-RA-SD.lia/MPT-04-01-XX-X-RA-SD.PcbLib
Part Libraries/ECAR_Refrence_Libary/OTHER/Imported MPT-04-01-XX-X-RA-SD.lia/MPT-04-01-XX-X-RA-SD.SchLib
Part Libraries/ECAR_Refrence_Libary/OTHER/Imported MPT-06-01-XX-X-RA-SD.lia/MPT-06-01-XX-X-RA-SD.PcbLib
Part Libraries/ECAR_Refrence_Libary/OTHER/Imported MPT-06-01-XX-X-RA-SD.lia/MPT-06-01-XX-X-RA-SD.SchLib
Part Libraries/ECAR_Refrence_Libary/OTHER/Imported Parts/Imported MPT-02-6.30-XX-X-V.lia/MPT-02-6.30-XX-X-V.PcbLib
Part Libraries/ECAR_Refrence_Libary/OTHER/Imported Parts/Imported MPT-02-6.30-XX-X-V.lia/MPT-02-6.30-XX-X-V.SchLib
Part Libraries/ECAR_Refrence_Libary/OTHER/SW3639/Eagle files/Imported NTAG I2C plus Class4 Antenna v1.PrjPcb/NTAG I2C plus Class4 Antenna v1.PrjPcb
Part Libraries/ECAR_Refrence_Libary/OTHER/SW3639/Eagle files/Imported NTAG I2C plus Class4 Antenna v1.PrjPcb/NTAG I2C plus Class4 Antenna v1.SchDoc
Part Libraries/ECAR_Refrence_Libary/Supporting Libaries/Imported 1-406541-5.lia/1-406541-5.PcbLib
Part Libraries/ECAR_Refrence_Libary/Supporting Libaries/Imported 1-406541-5.lia/1-406541-5.SchLib
Part Libraries/ECAR_Refrence_Libary/Supporting Libaries/Imported 5103308-2.lia/5103308-2.PcbLib
Part Libraries/ECAR_Refrence_Libary/Supporting Libaries/Imported 5103308-2.lia/5103308-2.SchLib
Part Libraries/ECAR_Refrence_Libary/Supporting Libaries/Imported KMR221GLFS.lia/KMR221GLFS.PcbLib
Part Libraries/ECAR_Refrence_Libary/Supporting Libaries/Imported KMR221GLFS.lia/KMR221GLFS.SchLib
Part Libraries/Old Libary/ECAR_LIBARY.SchLib
Part Libraries/Old Libary/ECAR_PARTS.PcbLib
Part Libraries/Old Libary/OLD_MainBoard.PcbLib
