EmbeddedSystemClass/Motor-Driver/Part Libraries/ECAR_Refrence_Libary/OTHER/SW3639/Eagle files/NTAG I2C plus Class4 Antenna v1.brd

## EAGLE design Part Libraries/ECAR_Refrence_Libary/OTHER/SW3639/Eagle files/NTAG I2C plus Class4 Antenna v1.brd (2019-07-14)

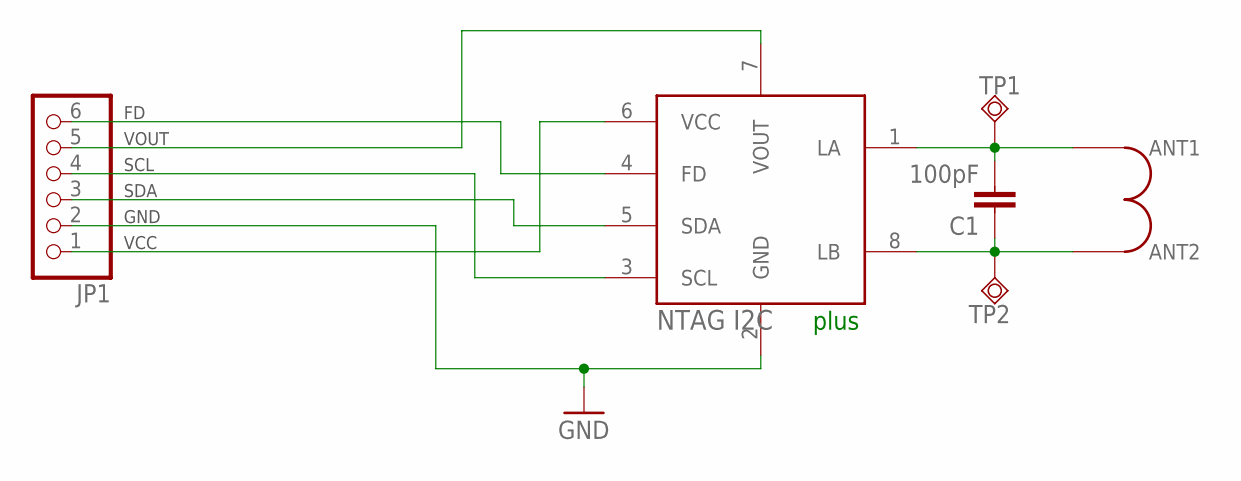
[picture p40: schematic NTAG I2C plus Class4 Antenna v1.sch]

Parts:
C1: 100pF; C0402K
JP1: PINHD-1X6/90; 1X06/90
TP1, TP2: TPSQPAD1-13; P1-13
U$1: ENERGY-HARVESTING_3-TURNS54X27_3TURN_THIN; 54X27_3TURNS_THIN
U$3: NTAG_I2CXQFN8; SOT902-3

Connections:
GND: JP1.2, U$3.2 (GND)
unnamed: C1.2, TP1.TP, U$1.ANT1, U$3.1 (LA)
unnamed: C1.1, TP2.TP, U$1.ANT2, U$3.8 (LB)
unnamed: JP1.1, U$3.6 (VCC)
unnamed: JP1.3, U$3.5 (SDA)
unnamed: JP1.4, U$3.3 (SCL)
unnamed: JP1.6, U$3.4 (FD)
unnamed: JP1.5, U$3.7 (VOUT)

Notes on the sheet:
VOUT
SCL
SDA
GND
VCC
plus

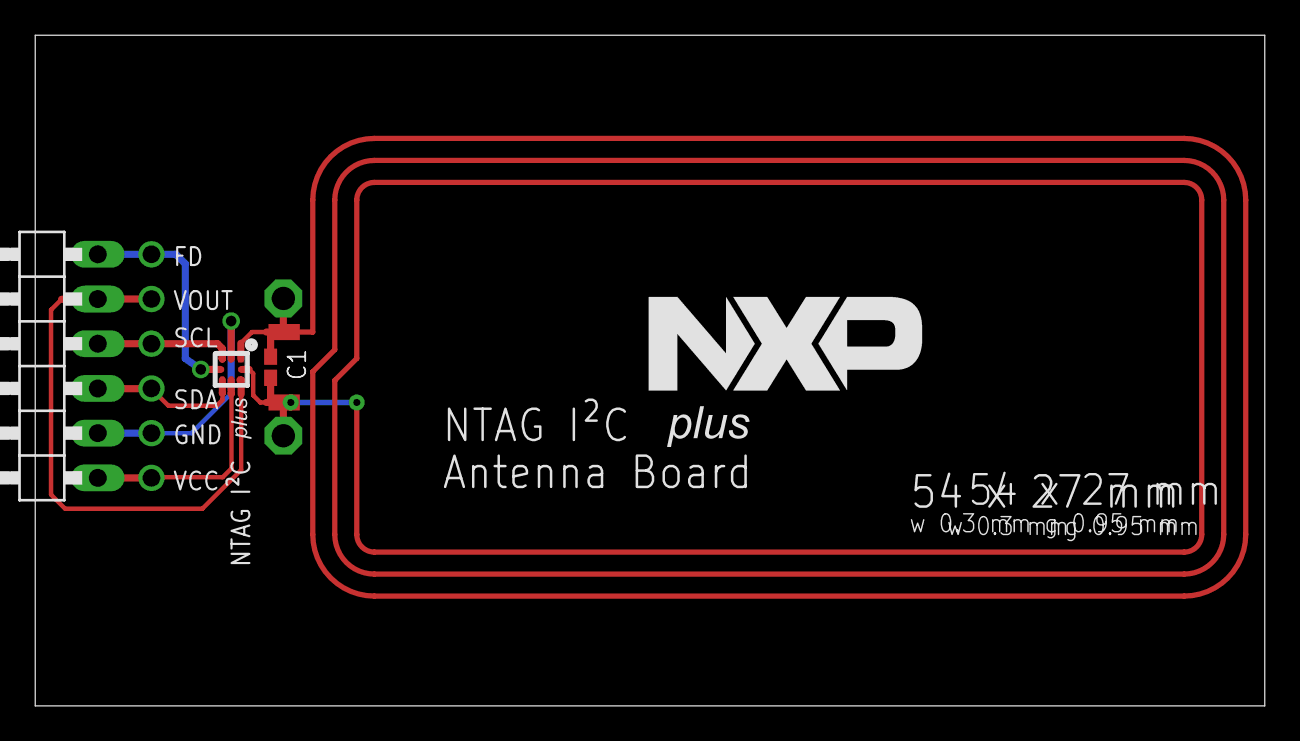
[picture p41: board NTAG I2C plus Class4 Antenna v1.brd from above]

Board: 2 copper layers, 69.8 x 38.1 mm, 6 parts (0 on the bottom side), 8 nets.
