EmbeddedSystemClass/Motor-Driver/(commit log)

2019-07-14 Addition of all files from 2018-2019
    [3.3V Regulator.SchDoc, Connectors & LEDs.SchDoc, ECAR_PARTS.PcbLib, EReference-PCB.PcbLib, Gate Driver & H-Bridge.SchDoc, MOSFET Board Layout.PcbDoc, MOSFET Board Project.PrjPCB, MOSFET Board Schematic Library.SchLib]
2019-07-14 Addition of part libaries and gitignore
    [039300240.stp, 1-406541-5.PcbLib, 1-406541-5.SchLib, 1722981104.stp, 5103308-2.PcbLib, 5103308-2.SchLib, ASV.STEP, CARD EDGE.stp]
2019-07-15 Creation of 2020 board project
    [3.3V Regulator.SchDoc, Connectors & LEDs.SchDoc, Gate Driver & H-Bridge.SchDoc, Gate Driver and Power Section.SchDoc, Motor Driver Board 2019-2020.PrjPcb, Power_Board_Layout_V2.PcbDoc]
2019-07-19 Reoranization
    Brought the old board project into Motor Folder 2019-2020
    Reorganization of project folder
    [Gate Driver and Power Section.SchDoc, Power_Board_Layout_V2.PcbDoc]
2019-09-01 Update Gate Driver and Power Section.SchDoc
    [Gate Driver and Power Section.SchDoc]
2019-09-03 LM regulator
    [EReference-Schematic.SchLib]
2019-09-15 changed net on nSHN
    [Gate Driver and Power Section.SchDoc]
2019-09-25 Addition of input filter on throttle and the addition of the hall effect input digital gates (Schmitt and level translation)
    [Connectors and Inputs.SchDoc, EReference-PCB.PcbLib, EReference-Schematic.SchLib, Gate Driver and Power Section.SchDoc, MCU and Digital Interfaces.SchDoc, Motor Driver Board 2019-2020.PrjPcb]
2019-09-26 Fix of schematic layout and symbols for 3.3V and 5V power supply. Initial work on MOSFET power bridge
    [EReference-PCB.PcbLib, EReference-Schematic.SchLib, Gate Driver and Power Section.SchDoc, MCU and Digital Interfaces.SchDoc, Motor Driver Board 2019-2020.PrjPcb]
2019-09-27 Addition of SD Card, addition of the tempature sensors for Fets. Completion of motor driver chip circuit, completion of the FET power stage.
    [EReference-PCB.PcbLib, EReference-Schematic.SchLib, Gate Driver and Power Section.SchDoc, MCU and Digital Interfaces.SchDoc, WSL2726 (0.0013).step]
2019-09-27 Additon of the encoder input interface. Also added in the input connector circuits for the encoder and hall effect sensors
    [Connectors and Inputs.SchDoc, EReference-PCB.PcbLib, EReference-Schematic.SchLib, IPL1-103-01-L-D-RA-K.stp, MCU and Digital Interfaces.SchDoc]
2019-10-10 A crazy amount of components added. MCU and Digital Interfaces and Connectors and Inputs schematic pages finished, same as Power section sheet
    [Connectors and Inputs.SchDoc, EReference-PCB.PcbLib, EReference-Schematic.SchLib, Gate Driver and Power Section.SchDoc, IPL1-103-01-L-S-RA-K.stp, MCU and Digital Interfaces.SchDoc, MPT-02-6.30-01-L-V.stp, MPT-02-6.30-XX-X-V.PcbLib]
2019-10-17 Fixed Output Reg Pwr
    [Gate Driver and Power Section.SchDoc]
2019-10-19 small adjustments to 3.3reg and renaming couple of components
    [Gate Driver and Power Section.SchDoc]
2019-10-24 Some minor cosmetic fixes to the sheet
    [Connectors and Inputs.SchDoc, Gate Driver and Power Section.SchDoc, MCU and Digital Interfaces.SchDoc, Motor Driver Board 2019-2020.PrjPcb, Protection and Test Points.SchDoc]
2019-11-01 Addition of power anaylsis
    Added the power analysis for the 3.3V and 5V power rials into the 2020 folder
    [Power Anaylisis.xlsx]
2019-11-05 Addition of 5v regulator and led indication circuitry
    [Connectors and Inputs.SchDoc, EReference-PCB.PcbLib, EReference-Schematic.SchLib, Gate Driver and Power Section.SchDoc, MCU and Digital Interfaces.SchDoc, Motor Driver Board 2019-2020.PrjPcb, Title Page.SchDoc]
2019-11-05 Generation of schematic for design review
    [Gate Driver and Power Section.SchDoc, Title Page.SchDoc]
2019-11-07 modification
    zero ohm resistors, labeling, zener, encoder enable
    [Connectors and Inputs.SchDoc, EReference-PCB.PcbLib, EReference-Schematic.SchLib, Gate Driver and Power Section.SchDoc, MCU and Digital Interfaces.SchDoc, Structure - Flow Chart.SchDoc]
2019-11-08 Update ProjectGroup.DsnWrk
    Added to PMOS encoder enable configuration. Added parts
2019-11-15 Change of the throttle filter op-amp to address bandwidth and input bias problems. Also added simulation circuit and results in the simulation folder
    [MCU and Digital Interfaces.SchDoc]
2019-11-17 Re organization of a couple of schematic pages
    [Connectors and Inputs.SchDoc, MCU and Digital Interfaces.SchDoc]
2019-11-20 Checking of more blocks of the schematic.
    Removed the io expander, as its functionality is now covered by the expanded MCU socket.
    Changed the capacitors for the voltage input to the board. Simulated the voltage feedback circuit and then changed a resistor value to allow operation of the circuit up to 60V. Caps still need to be changed on the motor bridge
    [Connectors and Inputs.SchDoc, EReference-PCB.PcbLib, EReference-Schematic.SchLib, Gate Driver and Power Section.SchDoc, MCU and Digital Interfaces.SchDoc, Motor Driver Board 2019-2020.PrjPcb]
2019-11-22 Addition of power filter simulation files
2019-11-25 some foot print changes and sanity checking
    [Gate Driver and Power Section.SchDoc]
2019-11-25 sanity checking
    [Connectors and Inputs.SchDoc]
2019-12-01 Changes to the schematic. Almost at completion
    [Connectors and Inputs.SchDoc, Gate Driver and Power Section.SchDoc, MCU and Digital Interfaces.SchDoc]
2019-12-03 Checking of the DRV circuit
    [Connectors and Inputs.SchDoc, Gate Driver and Power Section.SchDoc, MCU and Digital Interfaces.SchDoc]
2019-12-03 Fix of the led indicator circuits.
    Also changed the 47nF capacitor to have a rating of 100V so that the board can work at 60V (was 50V rated before)
    [Gate Driver and Power Section.SchDoc, MCU and Digital Interfaces.SchDoc]
2019-12-05 Verification of the FET bridge
    [Gate Driver and Power Section.SchDoc, Motor Driver Board 2019-2020.PrjPcb]
2019-12-08 Update of the main power in connector to the bolt on board 4 pin variant. Should cut down on the amount of heating seen at the connector
    [Connectors and Inputs.SchDoc, EReference-PCB.PcbLib, EReference-Schematic.SchLib, Gate Driver and Power Section.SchDoc, MCU and Digital Interfaces.SchDoc, MPT-04-01-01-L-RA-SD.stp, MPT-04-01-XX-X-RA-SD.PcbLib, MPT-04-01-XX-X-RA-SD.SchLib]
2019-12-08 Change of main phase connector from 3 pin to 6 pin to increase current capability and allow for a more robust connector
    [Connectors and Inputs.SchDoc, EReference-PCB.PcbLib, EReference-Schematic.SchLib, MPT-06-01-03-L-RA-SD.stp, MPT-06-01-XX-X-RA-SD.PcbLib, MPT-06-01-XX-X-RA-SD.SchLib]
2019-12-12 Final checks performed. Schematic should be ready for board creation
    [Connectors and Inputs.SchDoc, Gate Driver and Power Section.SchDoc, MCU and Digital Interfaces.SchDoc]
2020-01-03 Push of the initial layout
    [BLDC-2020.PcbDoc, Connectors and Inputs.SchDoc, EReference-PCB.PcbLib, EReference-Schematic.SchLib, Gate Driver and Power Section.SchDoc, MCU and Digital Interfaces.SchDoc, Motor Driver Board 2019-2020.PrjPcb]
2020-01-04 Throttle section practice
    [BLDC-2020.PcbDoc]
2020-01-04 More practicing, placed Schmitt hall Schmit components
2020-01-05 Added the Encoder section
2020-01-05 net fixing
    [MCU and Digital Interfaces.SchDoc]
2020-01-05 GPIO buffers and connectors
2020-01-06 Power section and driver chip finished
    [Connectors and Inputs.SchDoc, EReference-PCB.PcbLib, EReference-Schematic.SchLib, Gate Driver and Power Section.SchDoc, Motor Driver Board 2019-2020.PrjPcb]
2020-01-11 Hopefully the right files
    [Gate Driver and Power Section.SchDoc]
2020-01-13 Testest
    Commiting finaly
    [BLDC-2020.PcbLib, Gate Driver and Power Section.SchDoc, Motor Driver Board 2019-2020.PrjPcb, Motor Driver Board 2019-2020.SCHLIB]
2020-01-15 placing GPIO buffer
    testing git
    [Motor Driver Board 2019-2020.PrjPcb]
2020-01-16 Added 5v power
    Practicing with the polygon pour. May need to change and edit.
2020-01-16 Getting close to complete
    [Connectors and Inputs.SchDoc]
2020-01-17 Revert "Merge branch 'master' of github.com:UOERacing/Motor-Driver"
    This reverts commit 896bb1447881fe9900ef6cad67ef5cf2d1325141, reversing
    changes made to bacd3aeafff96990d78e3a7c32f37b9bf0d5d698.
    [Motor Driver Board 2019-2020.PrjPcb]
2020-01-17 Update Motor Driver Board 2019-2020.PrjPcb
    [Motor Driver Board 2019-2020.PrjPcb]
2020-01-18 Completion of routing
    [Connectors and Inputs.SchDoc, Gate Driver and Power Section.SchDoc, MCU and Digital Interfaces.SchDoc]
2020-01-19 Footprint fix, silk screen fixing and TP naming
    [Connectors and Inputs.SchDoc, EReference-PCB.PcbLib, EReference-Schematic.SchLib, Gate Driver and Power Section.SchDoc, MCU and Digital Interfaces.SchDoc, Motor Driver Board 2019-2020.PrjPcb]
2020-01-26 Change of mounting hole size to 3.5mm as per Simons instructions
2020-01-26 Minor silk correction and pass of the DRC
    [Gate Driver and Power Section.SchDoc, MCU and Digital Interfaces.SchDoc, Motor Driver Board 2019-2020.PrjPcb]
2020-01-27 Small finishing touches to the board. Now missing only logo for team
2020-01-27 Project ready for Review
    [Motor Driver Board 2019-2020.PrjPcb, Title Page.SchDoc]
2020-01-31 Footprint Fixes, Silk Screen Fix.
    Polygon pour at the 3v3 regulator Inductor needs some adjusting as well as some component placement
    [Connectors and Inputs.SchDoc, EReference-PCB.PcbLib, Gate Driver and Power Section.SchDoc, MCU and Digital Interfaces.SchDoc, Motor Driver Board 2019-2020.PrjPcb, Title Page.SchDoc]
2020-02-03 Addition of Gerber files and fix of polygon attached to inductor. Slight silkscreen changes
    [Motor Driver Board 2019-2020.PrjPcb]
2020-02-07 Tied the enable for the 3.3V regulator to the pwr good indicator of the 5V Regualtor
    [Gate Driver and Power Section.SchDoc, Motor Driver Board 2019-2020.PrjPcb]
2020-02-08 Revert "na"
    This reverts commit 1781cdccb237cffe15a9127709c46b1f825b080e.
    [Motor Driver Board 2019-2020.PrjPcb]
2020-02-11 Addition of enable pull up resistor on 3.3V regulator in case the power good line from 5V is not working correctly
    [Gate Driver and Power Section.SchDoc, Motor Driver Board 2019-2020.PrjPcb]
2020-02-11 C13, 15, 16 rerouted due to voltage tolerances not being high enough . C15 changed to meet requirement and placed on board
    [Gate Driver and Power Section.SchDoc, Motor Driver Board 2019-2020.PrjPcb]
2020-02-12 Capacitor Update finished
    [EReference-Schematic.SchLib, Gate Driver and Power Section.SchDoc, Motor Driver Board 2019-2020.PrjPcb]
2020-02-16 ActiveBom File created
    [Gate Driver and Power Section.SchDoc, Motor Driver Board 2019-2020.PrjPcb]
2020-02-27 Generation of RFM rev manufacturing files
    [Motor Driver Board 2019-2020.PrjPcb]
2020-05-09 Additions to parts library for transmitter
    [EReference-PCB.PcbLib, EReference-Schematic.SchLib]
